Lain-Ego0/HighTorque-MiniDog/3.Document/7路CAN主控盒子资料/文档资料/01、python-SDK环境配置.pdf

# 01、python-SDK环境配置

## python-SDK环境配置

### 1. 下载程序

将程序下载在主机中，文件名为hightorque_robot

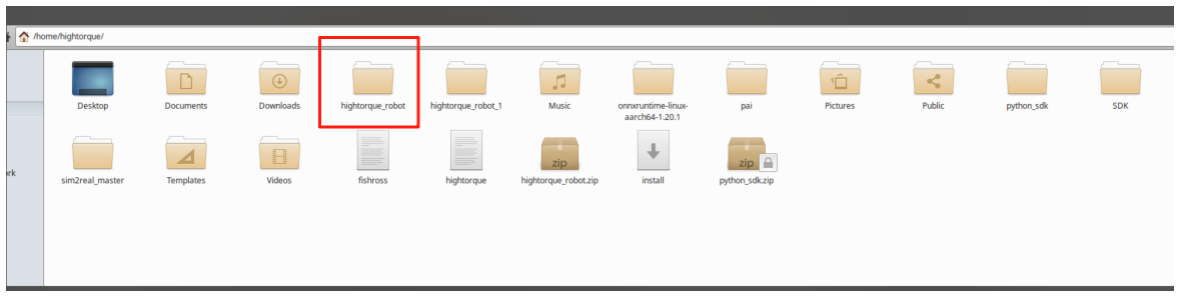
[picture p6: figure]

### 2. 下载系统依赖

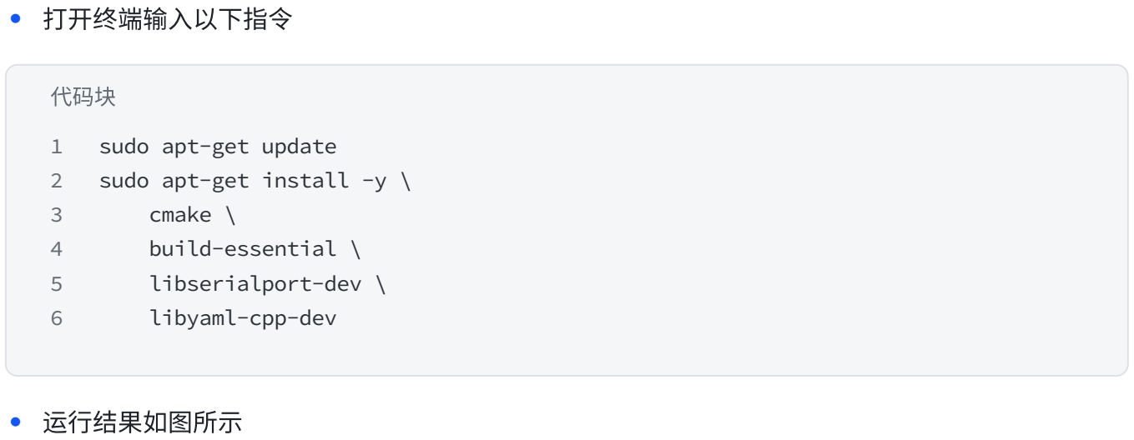
[picture p7: figure]
• 打开终端输入以下指令; 代码块; sudo apt-get update sudo apt-get install -y \ cmake \ build-essential \ libserialport-dev \ libyaml-cpp-dev; • 运行结果如图所示
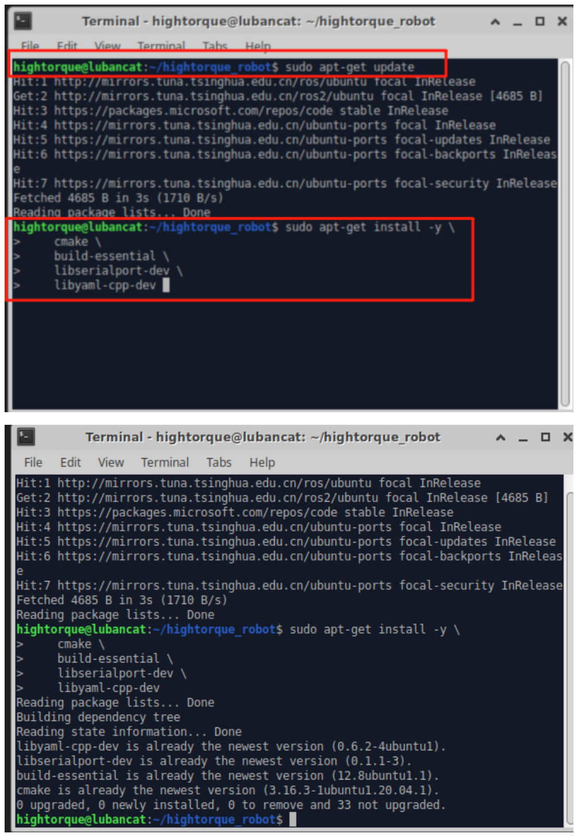
[picture p8: page 2]
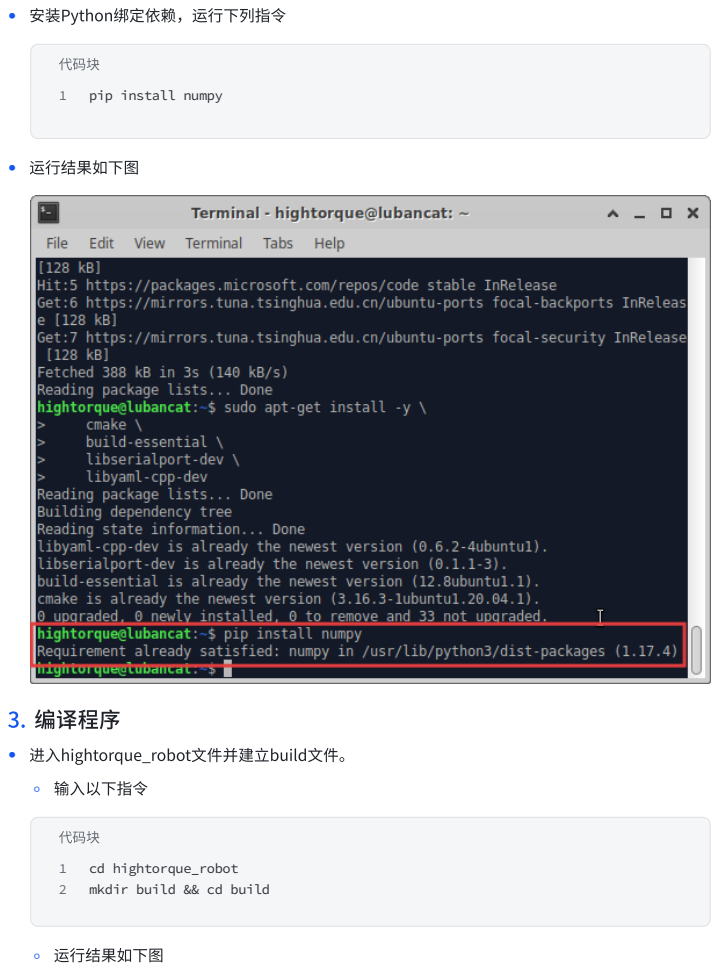
[picture p9: page 3]
• 安装Python绑定依赖，运行下列指令; • 运行结果如下图; 3. 编译程序; • 进入hightorque_robot文件并建立build文件。; ◦ 输入以下指令; ◦ 运行结果如下图

代码块
pip install numpy

cd hightorque_robot
mkdir build && cd build

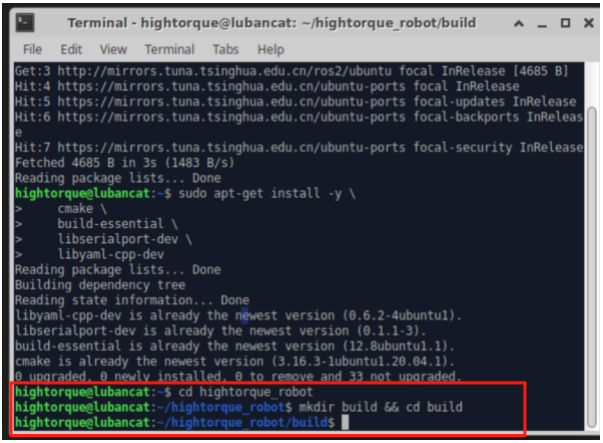
[picture p10: figure]
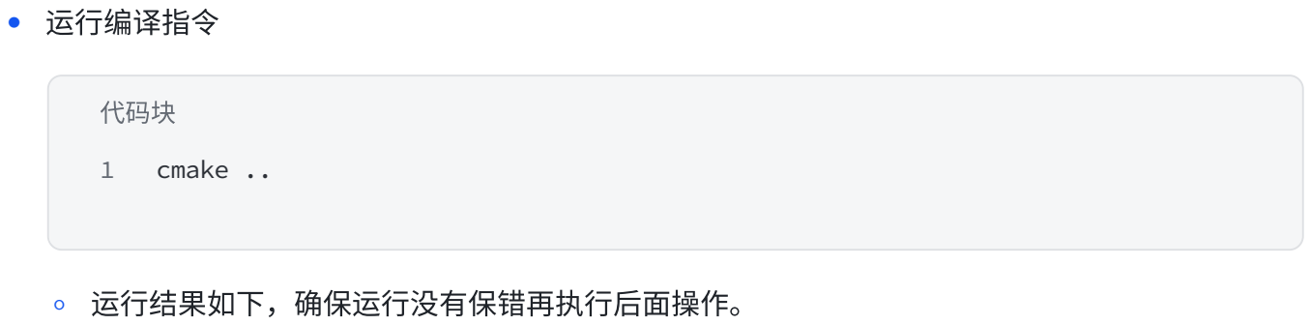
[picture p11: figure]
• 运行编译指令; 代码块; cmake ..; ◦ 运行结果如下，确保运行没有保错再执行后面操作。
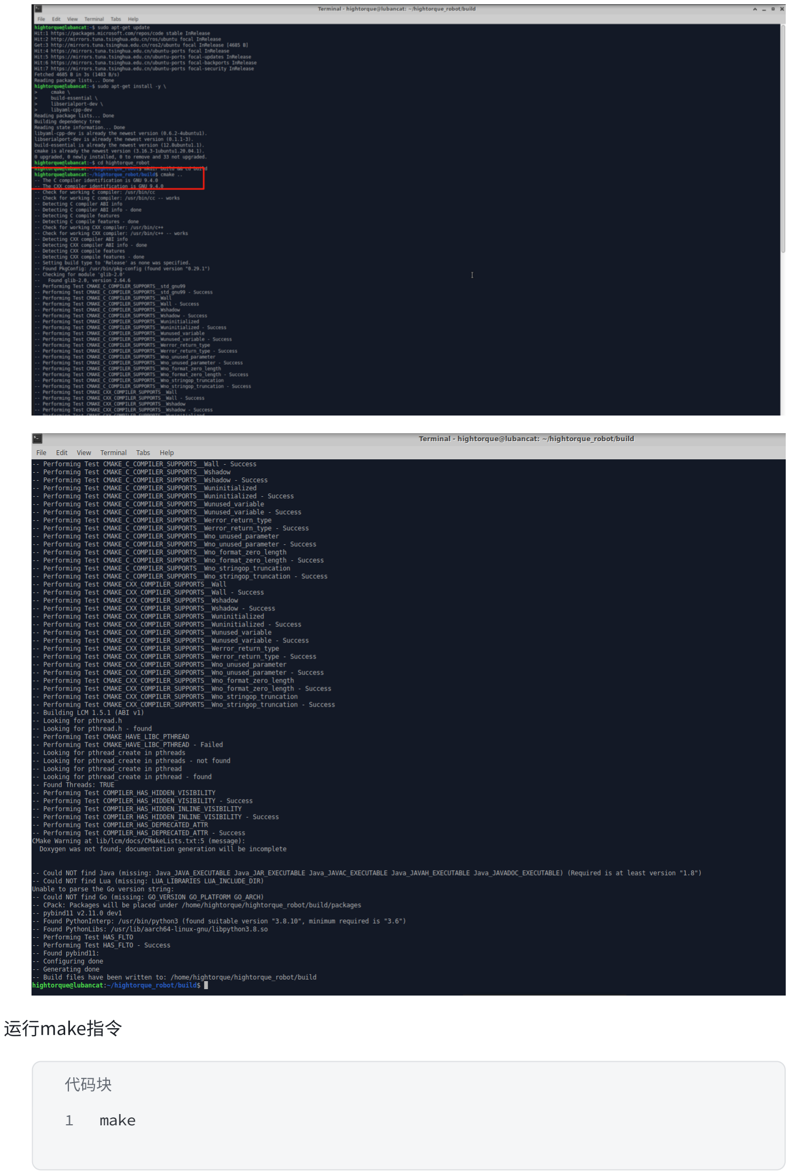
[picture p12: page 5]

运行make指令

代码块

### 1 make

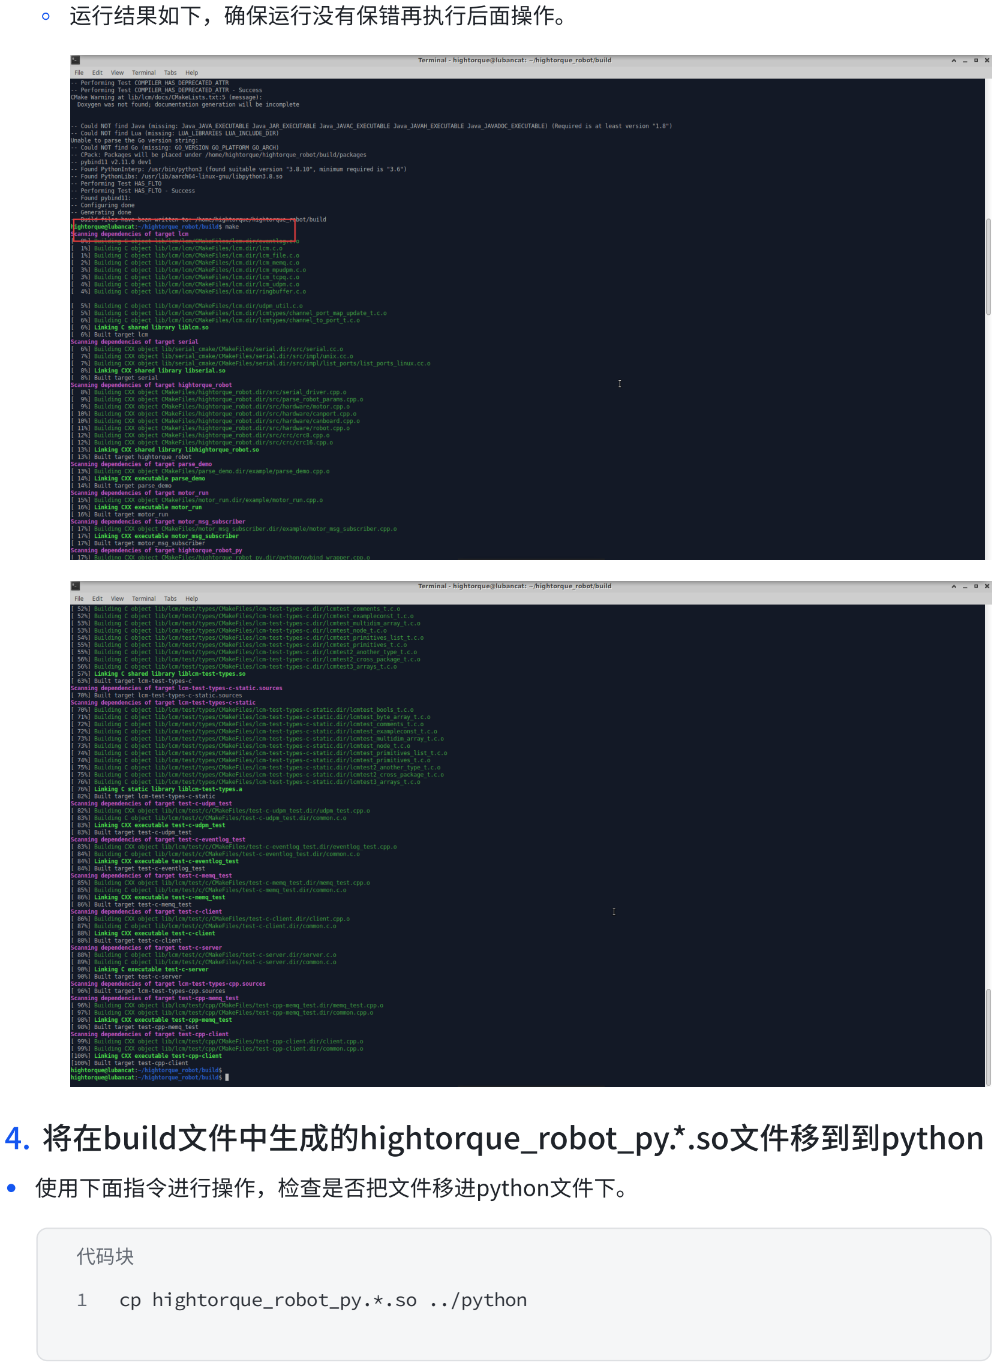
[picture p13: page 6]

- 运行结果如下，确保运行没有保错再执行后面操作。

## 4. 将在build文件中生成的hightorque_robot_py.*.so文件移到到python

- 使用下面指令进行操作，检查是否把文件移进python文件下。

代码块

### 1 cp hightorque_robot_py.*.so ../python

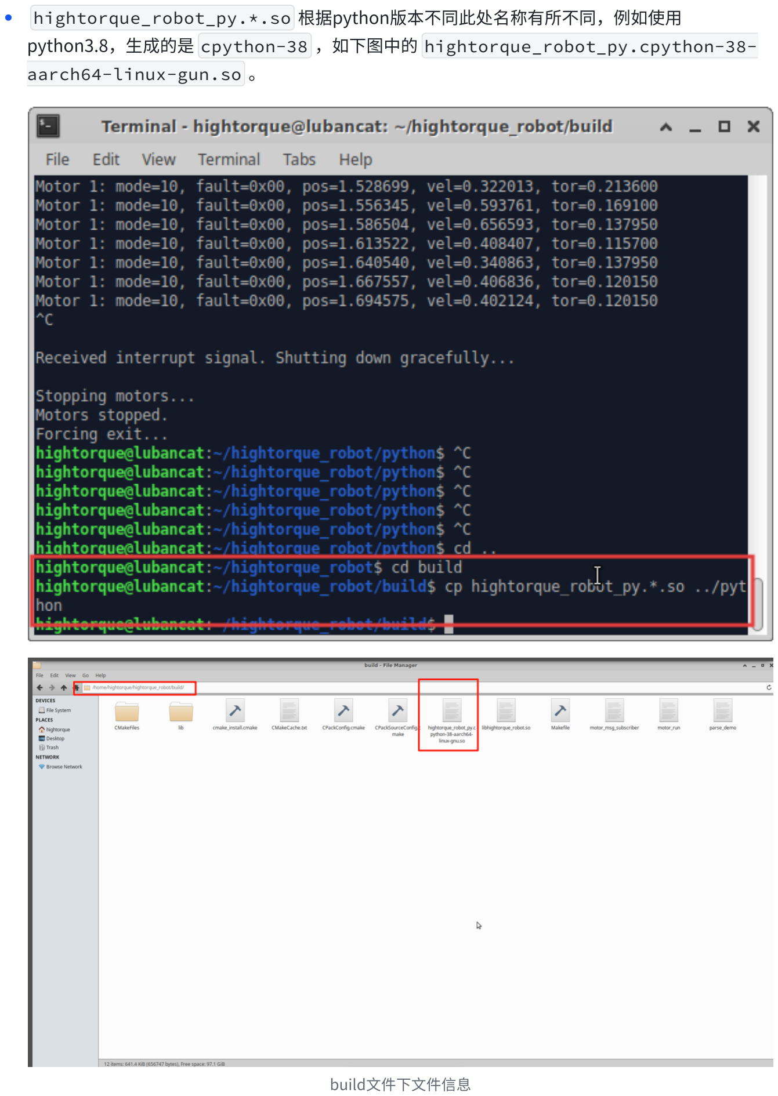
[picture p14: page 7]

- hightorque_robot_py.*.so 根据python版本不同此处名称有所不同，例如使用
python3.8，生成的是 cpython-38 ，如下图中的 | hightorque_robot_py.cpython-38-
aarch64-linux-gun.so | 。

build文件下文件信息

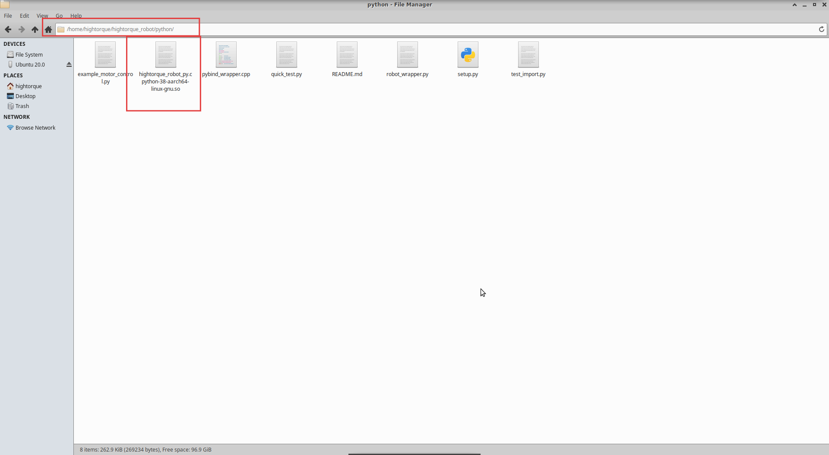
[picture p15: figure]

python文件下文件信息

## 5. 进入python文件运行测试程序

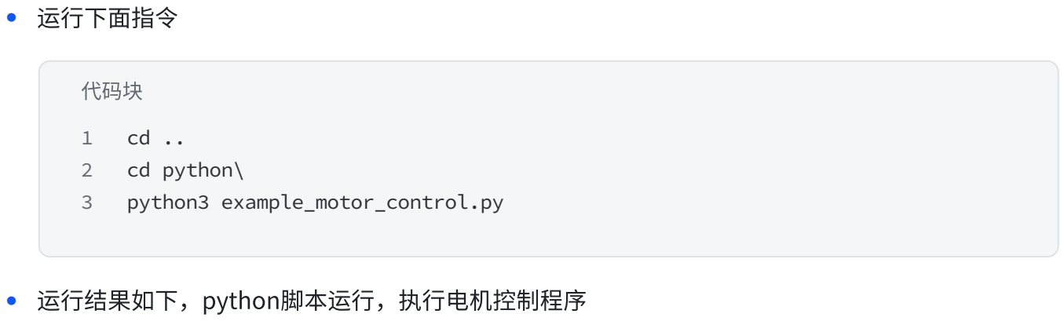
[picture p16: figure]
• 运行下面指令; 代码块; cd .. cd python\ python3 example_motor_control.py; • 运行结果如下，python脚本运行，执行电机控制程序

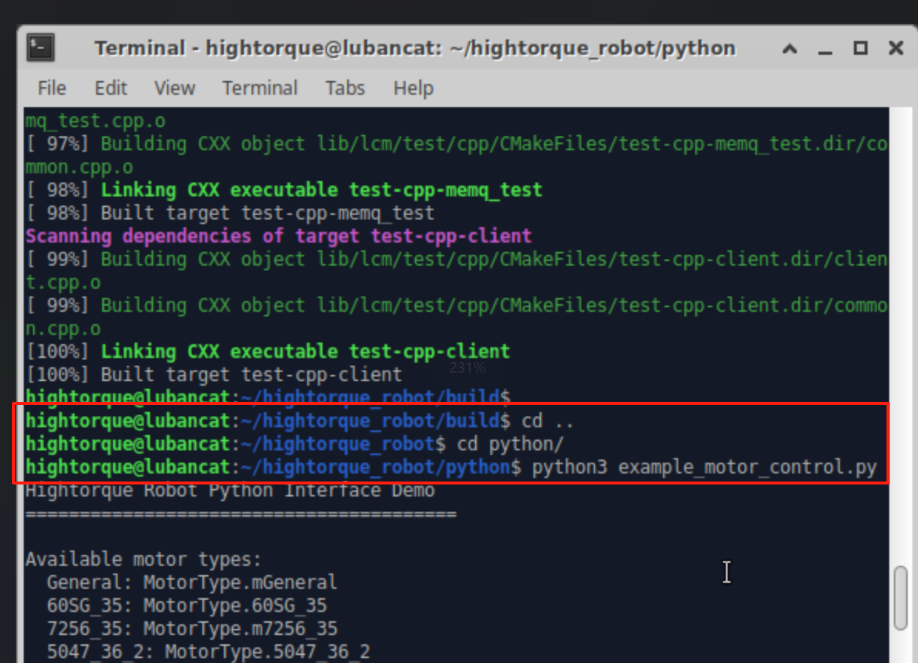
[picture p17: figure]
