Lain-Ego0/HighTorque-MiniDog/3.Document/高擎动力电池资料/电池参数.png

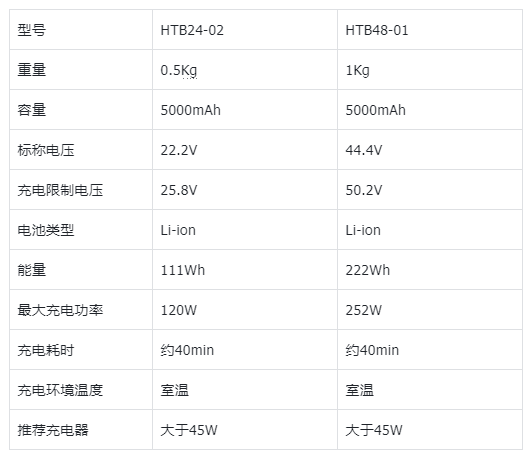
3.Document/高擎动力电池资料/电池参数.png
