Lain-Ego0/HighTorque-MiniDog/5.Images/V1.png

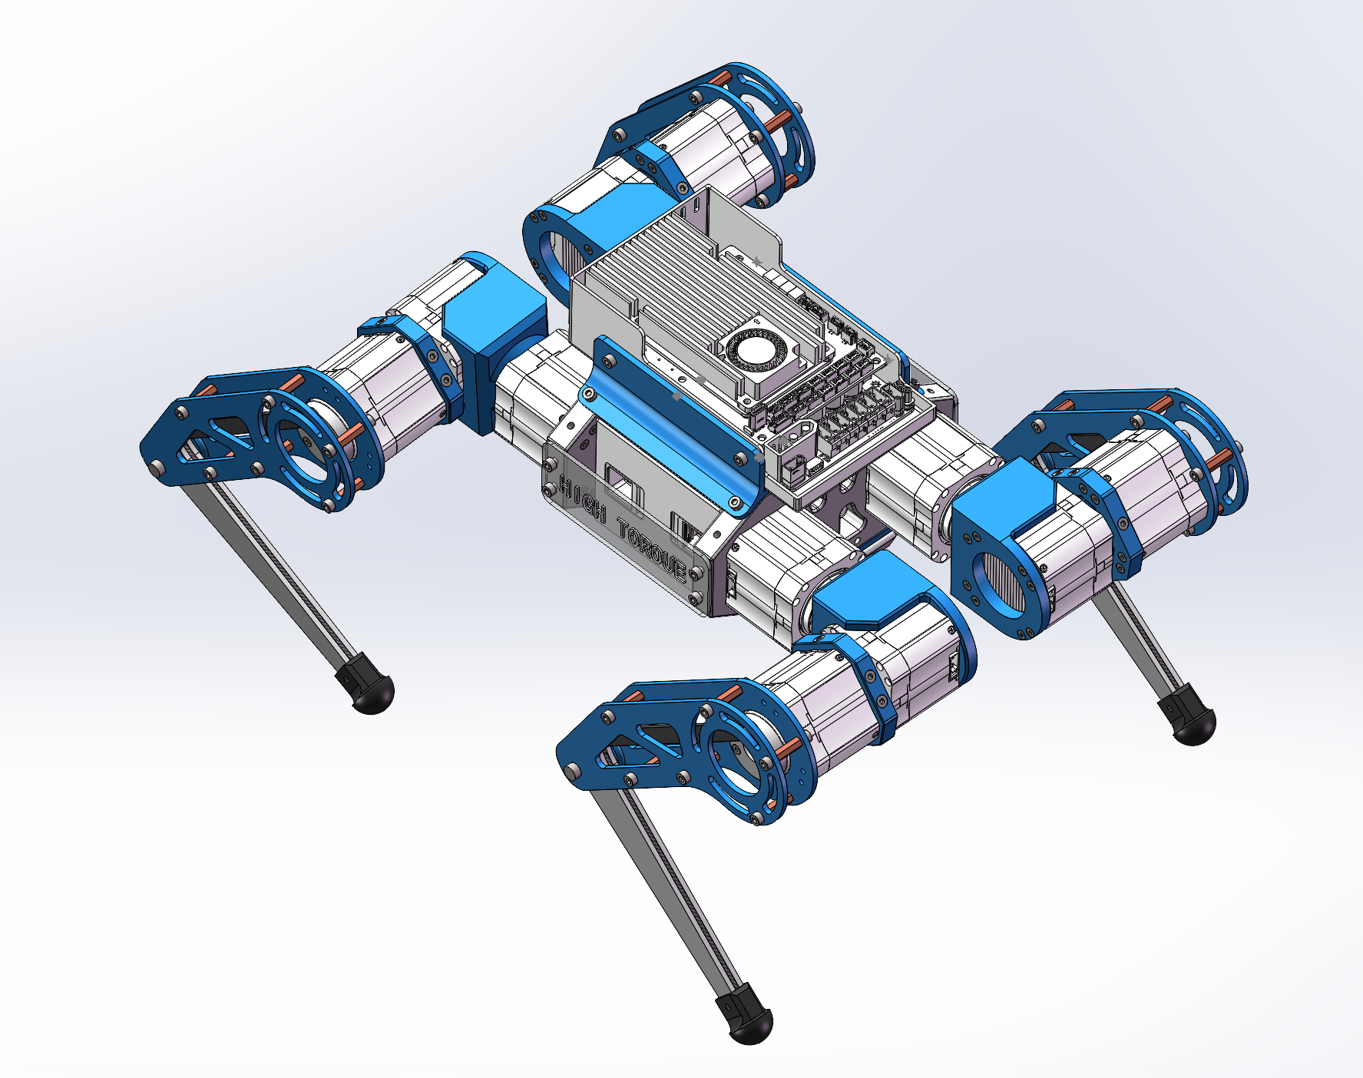
5.Images/V1.png
