Lain-Ego0/HighTorque-MiniDog/5.Images/V2.png

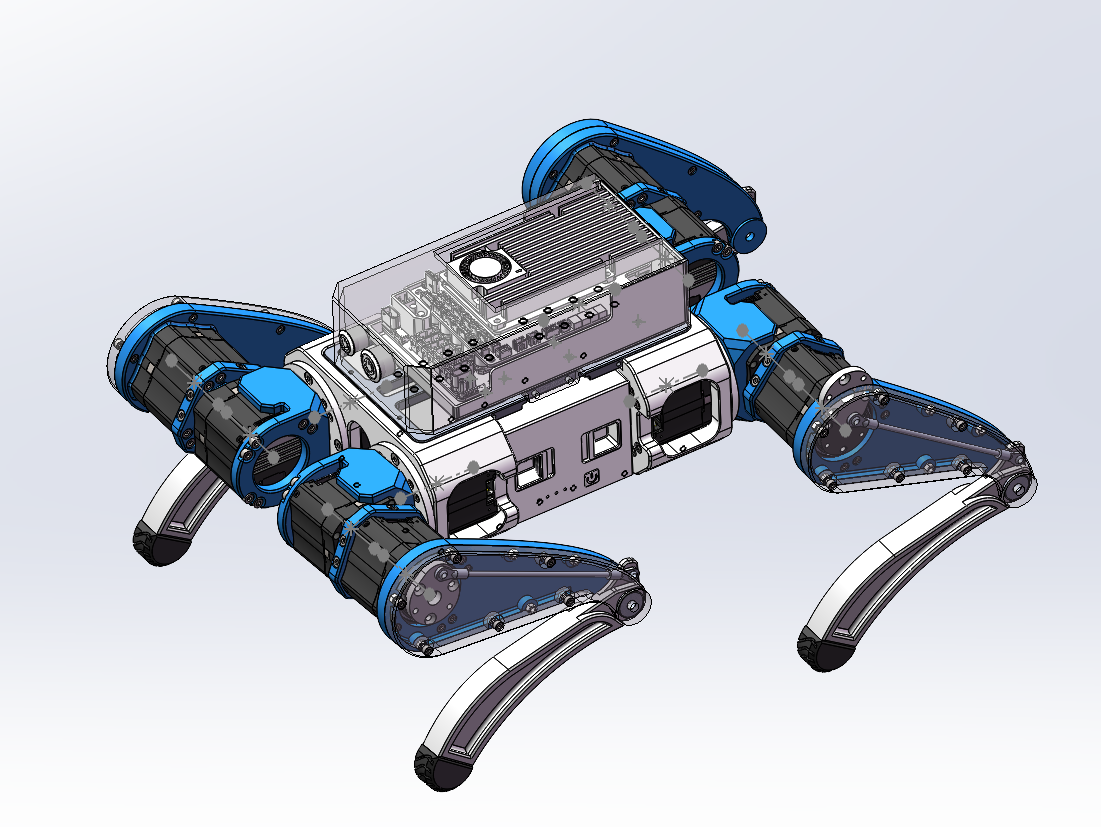
5.Images/V2.png
