Lain-Ego0/HighTorque-MiniDog/assets/image-20260120192404432.png

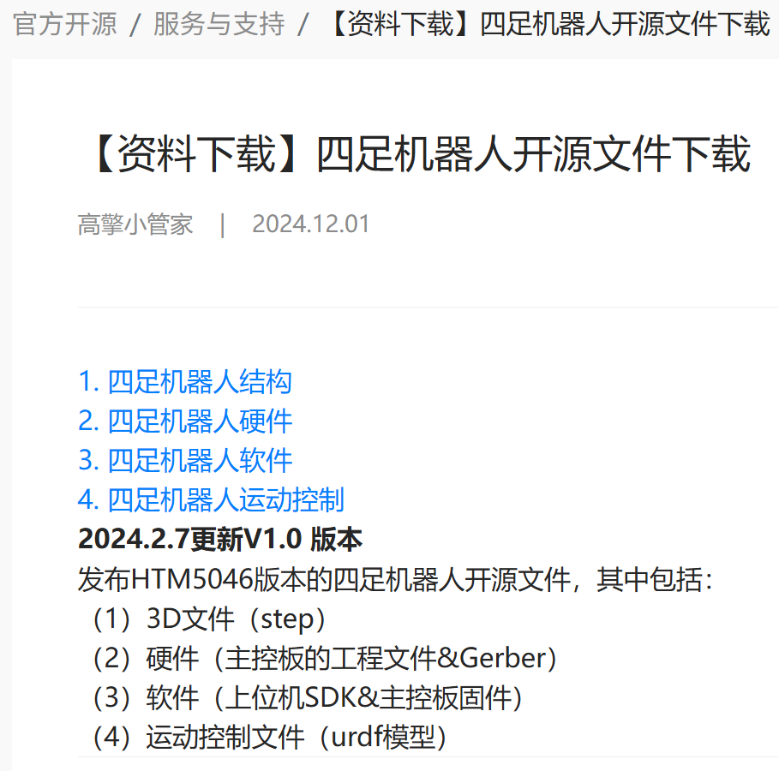
assets/image-20260120192404432.png
