Lain-Ego0/HighTorque-MiniDog/assets/image.png

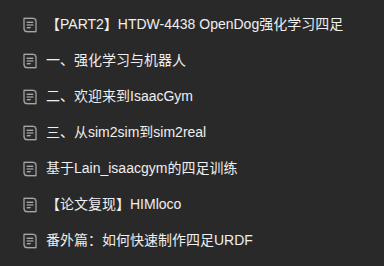
assets/image.png
