Lain-Ego0/HighTorque-MiniDog/BOM.xlsx

电机材料BOM表
商品简称 | 数量 | 单位 | 规格 | 型号 | 单价 | 总价 | 产品图片 | 链接
主控盒子 | 1 | 个 | 高擎机电 | RoBoBox-7C开发套件 RK3588核心板功率板 7路can | 2999 | 2999 | =DISPIMG("ID_BEA2C792CA2D4338877360D81E1C02E0",1) | https://item.taobao.com/item.htm?id=941964501774&skuId=5854163228933
HTM-4438 | 12 | 个 | 高擎机电 | HTM-4438 | 899 | 10788 | =DISPIMG("ID_2CC5A49AB6E142558D87F2EC8AF307A8",1) | https://item.taobao.com/item.htm?id=776280863227&skuId=5833834236346
高擎机电自研 BMS电池 | 1 | 个 | 高擎机电 | HTB24（24V） | 899 | 899 | =DISPIMG("ID_F9912B83E9324EAC948459F9C720646A",1) | https://item.taobao.com/item.htm?id=940034270930&skuId=6003633490738
XT30（2+2） | 12 | 条 | 高擎机电 | XT30（2+2）CAN端子线材 |  |  | =DISPIMG("ID_088166CB696247348FEB7CAEBC6838D0",1) | https://item.taobao.com/item.htm?id=940637805222&skuId=5836913516511
usb转can模块 | 1 | 个 | 高擎机电 | 电机调试器USB转CANFD | 88 | 88 | =DISPIMG("ID_DE37467A45FB48D49FF0A2E2A4B48DCD",1) | https://item.taobao.com/item.htm?id=803596739458&skuId=5838408897102
材料购买表
商品简称 | 数量 | 单位 | 规格 | 型号 |  |  | 产品图片 | 链接 | 用途
杯头螺丝 | 1 | 件 | M2.5*20[50个] | SZ105-国标DIN912 | 4.8 | 4.8 | =DISPIMG("ID_5A68CB2C8CF24C4B8B75CCBF4D84C922",1)
杯头螺丝 | 1 | 件 | M3*10[50个] | SZ105-国标DIN912 | 2.7 | 2.7 | =DISPIMG("ID_DF31851D3177447E9443667D950D5D3B",1)
杯头螺丝 | 1 | 件 | M3*12[50个] | SZ105-国标DIN912 | 3 | 3 | =DISPIMG("ID_CCA8D6D92B4B4D15A3308F70EC4EE083",1)
杯头螺丝 | 1 | 件 | M3*15[50个] | SZ105-国标DIN912 | 3.6 | 3.6 | =DISPIMG("ID_BB62620DB465445DBE867C79ED09E9B8",1)
杯头螺丝 | 1 | 件 | M3*25[50个] | SZ105-国标DIN912 | 4.5 | 4.5 | =DISPIMG("ID_6C18F41A81C94DC6A925279E1ABA02BE",1)
杯头螺丝 | 1 | 件 | M3*35[50个] | SZ105-国标DIN912 | 2.7 | 2.7 | =DISPIMG("ID_9DF53531F7B04B88BADECE2428534E32",1)
杯头螺丝 | 1 | 件 | M3*40[50个] | SZ105-国标DIN912 | 3.1 | 3.1 | =DISPIMG("ID_303DC5F60FD74723B0BED9BF9463948D",1)
杯头螺丝 | 1 | 件 | M5*20[20个] | SZ105-国标DIN912 | 3.9 | 3.9 | =DISPIMG("ID_ECDE7BB7A42643D2BEAAFBF641936D92",1)
杯头螺丝 | 1 | 件 | M5*30[10个] | SZ105-国标DIN912 | 2.5 | 2.5 | =DISPIMG("ID_E0697B837510405E99F7B9D1F8C5C177",1)
螺母 | 1 | 包 | M2.5【304材质】*20颗 | SZ124-003 | 3.6 | 3.6 | =DISPIMG("ID_4435505E4D3444C2B49B932C982A96F8",1)
螺母 | 1 | 包 | M3【304材质】*50颗 | SZ124-003 | 3.4 | 3.4 | =DISPIMG("ID_ED4B863F285F4AD9A9C094EA965BB35C",1)
螺母 | 1 | 包 | M5【304材质】*50颗 | SZ124-003 | 3.9 | 3.9 | =DISPIMG("ID_0244CC1D4A954542B4BEE1F289BDAF5E",1)
法兰轴承 | 3 | 件 | 5*13*4 10只 | F MF2-5 | 19 | 57 | =DISPIMG("ID_47ADE4DCB12949CF979BCA55C94982DE",1)
尼龙柱 | 1 | 包 | 3.2*5*25(100个) | 1170 | 9.5 | 9.5 | =DISPIMG("ID_37CDDA6D06C34113926942D377090F54",1)
轮胎 | 2 | 个 | 江昕5x2实心胎 | 5.5x2 | 30 | 60 | =DISPIMG("ID_6E9682AB056F46BB87A38954D99A1416",1)
垫片 | 1 | 包 | M5*8*0.5 [100粒 | GB97 | 3 | 3 | =DISPIMG("ID_CEC6477D13B24A38A034292F6B30D398",1)
