Lain-Ego0/HighTorque-MiniDog/1.Hardware/HTDW4438-OpenDogV1.5/铝-CNC连杆-发加工版本.SLDPRT

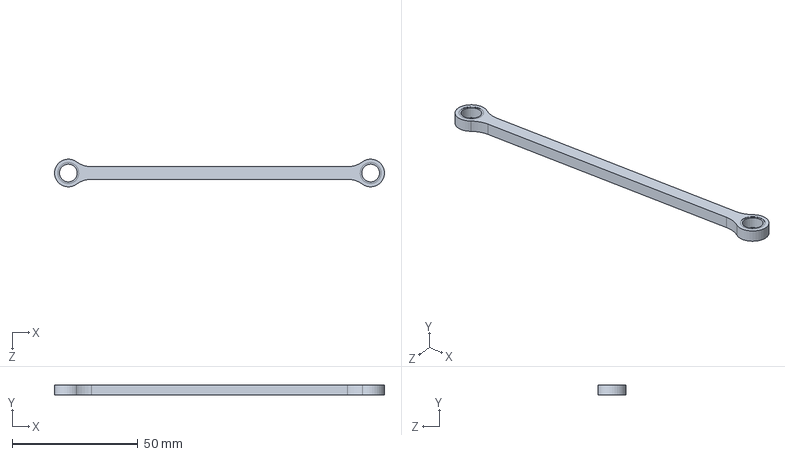
[picture p23: CAD file, 2026-01-23]
1.Hardware/HTDW4438-OpenDogV1.5/铝-CNC连杆-发加工版本.SLDPRT
131.0 x 4.00 x 11.0 mm
