Lain-Ego0/HighTorque-MiniDog/1.Hardware/HTDW4438-OpenDog（URDF）/hip^总装配体.SLDPRT

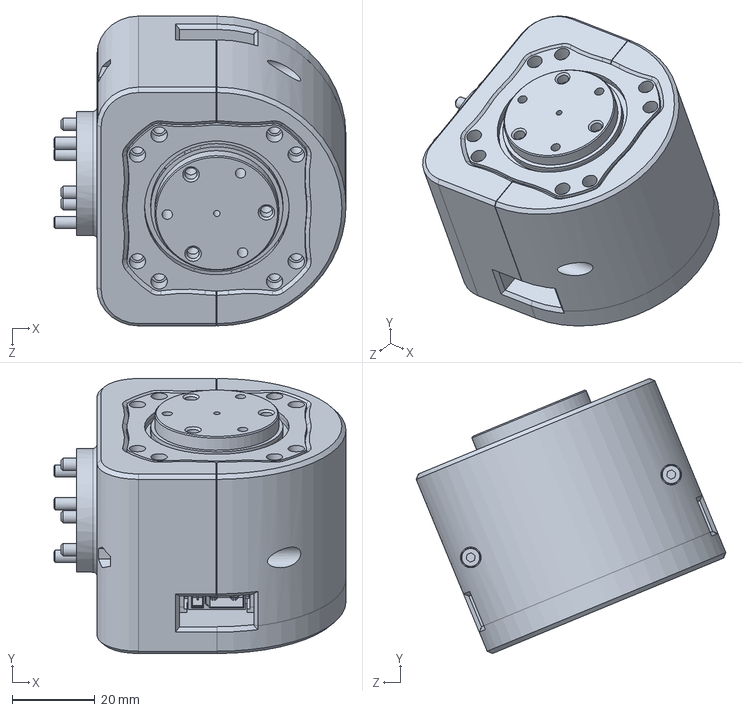
[picture p24: CAD file, 2026-01-23]
1.Hardware/HTDW4438-OpenDog（URDF）/hip^总装配体.SLDPRT
70.7 x 66.5 x 74.9 mm
