Lain-Ego0/HighTorque-MiniDog/1.Hardware/htdw_4438_urdf/meshes/RR_hip.STL

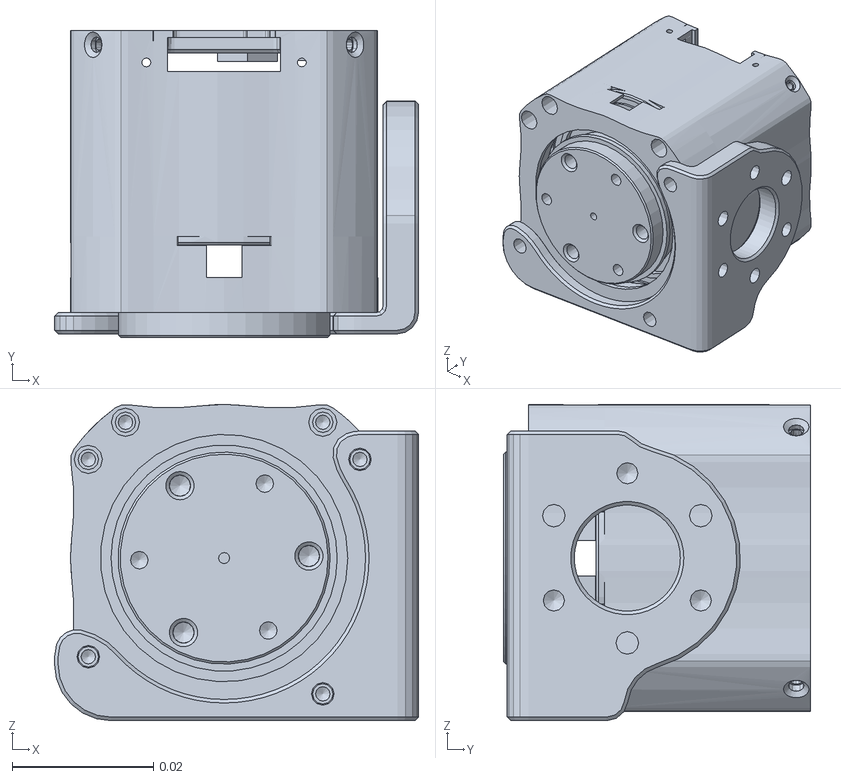
[picture p25: CAD file, 2026-03-19]
1.Hardware/htdw_4438_urdf/meshes/RR_hip.STL
0.0515 x 0.0434 x 0.0447
