Lain-Ego0/HighTorque-MiniDog/1.Hardware/HTDW4438-OpenDogV1.5/小腿1.SLDPRT

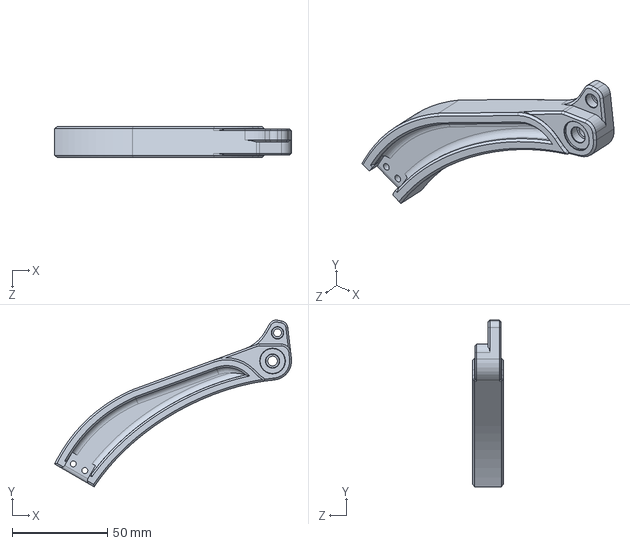
[picture p26: CAD file, 2026-01-23]
1.Hardware/HTDW4438-OpenDogV1.5/小腿1.SLDPRT
124.3 x 87.5 x 16.0 mm
