Lain-Ego0/HighTorque-MiniDog/1.Hardware/HTDW4438-OpenDog（URDF）/R_foot^总装配体.SLDPRT

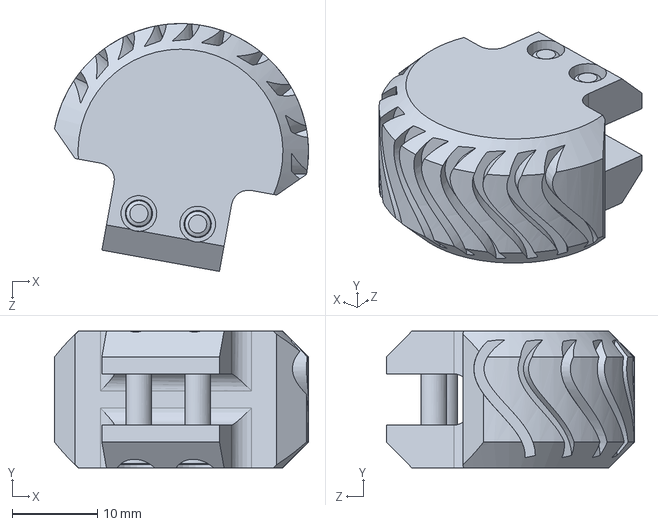
[picture p27: CAD file, 2026-01-23]
1.Hardware/HTDW4438-OpenDog（URDF）/R_foot^总装配体.SLDPRT
29.8 x 16.0 x 29.0 mm
