Lain-Ego0/HighTorque-MiniDog/1.Hardware/htdw_4438_urdf/meshes/FL_foot.STL

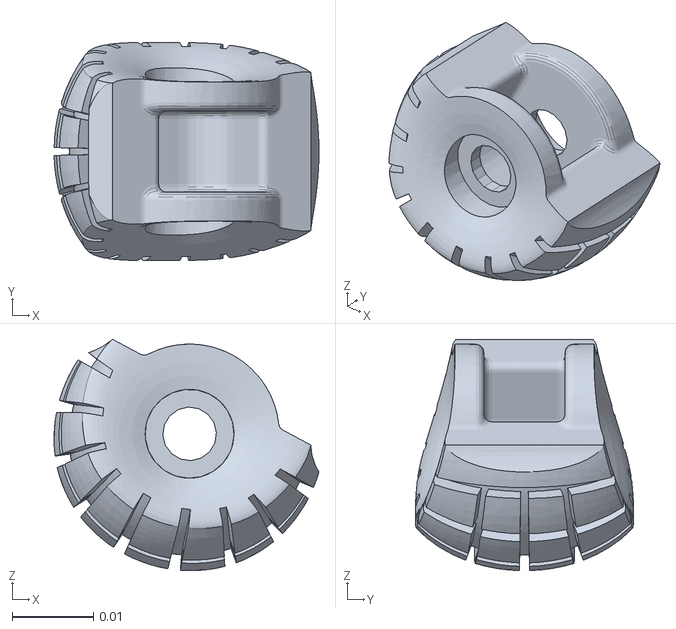
[picture p28: CAD file, 2026-03-19]
1.Hardware/htdw_4438_urdf/meshes/FL_foot.STL
0.0326 x 0.0269 x 0.0285
