Lain-Ego0/HighTorque-MiniDog/1.Hardware/HTDW4438-OpenDogV1.5/大腿内侧2.SLDPRT

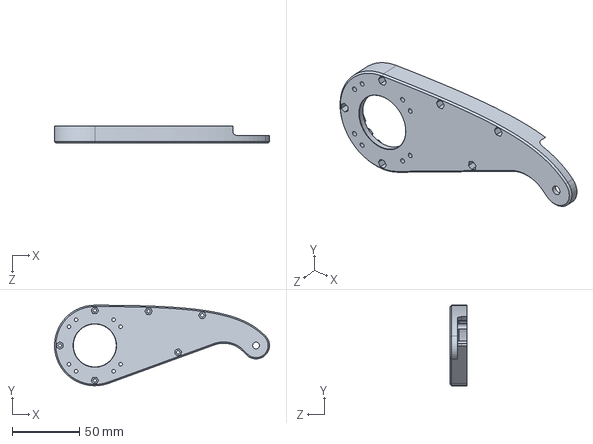
[picture p29: CAD file, 2026-01-23]
1.Hardware/HTDW4438-OpenDogV1.5/大腿内侧2.SLDPRT
160.0 x 60.0 x 12.5 mm
