Lain-Ego0/HighTorque-MiniDog/1.Hardware/HTDW4438-OpenDog（URDF）/R_calf^总装配体.SLDPRT

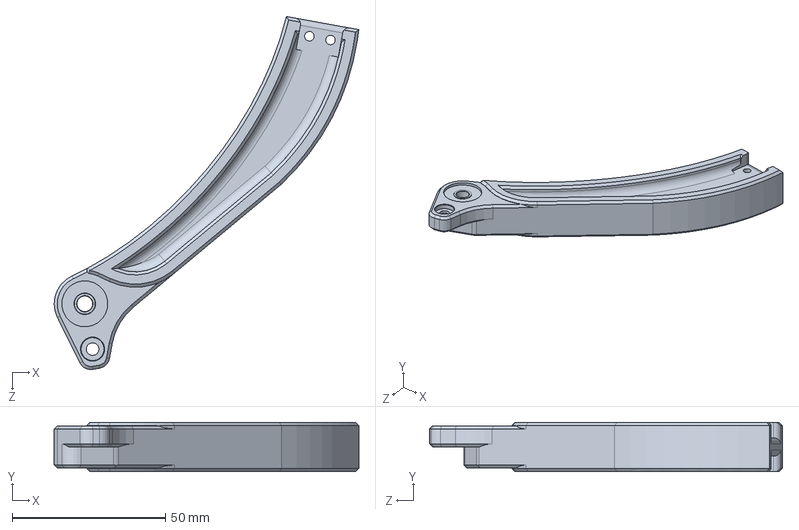
[picture p30: CAD file, 2026-01-23]
1.Hardware/HTDW4438-OpenDog（URDF）/R_calf^总装配体.SLDPRT
99.4 x 16.0 x 115.1 mm
