Lain-Ego0/HighTorque-MiniDog/1.Hardware/htdw_4438_urdf/meshes/FR_calf.STL

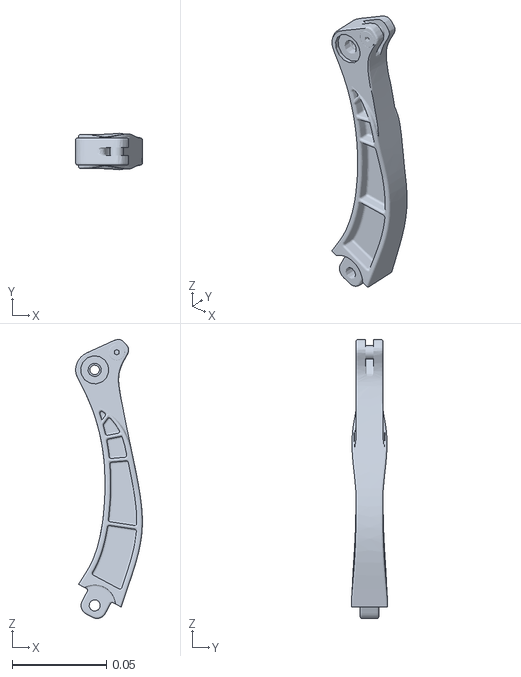
[picture p31: CAD file, 2026-03-19]
1.Hardware/htdw_4438_urdf/meshes/FR_calf.STL
0.0355 x 0.0194 x 0.148
