Lain-Ego0/HighTorque-MiniDog/1.Hardware/HTDW4438-OpenDogV1.5/髋关节连接2.SLDPRT

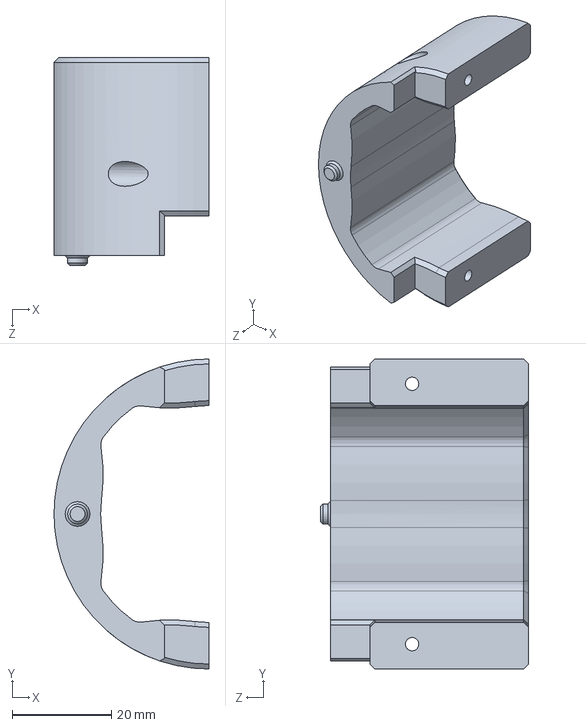
[picture p32: CAD file, 2026-01-23]
1.Hardware/HTDW4438-OpenDogV1.5/髋关节连接2.SLDPRT
31.2 x 62.5 x 42.0 mm
