Lain-Ego0/HighTorque-MiniDog/1.Hardware/HTDW4438-OpenDog（URDF）/L_foot^总装配体.SLDPRT

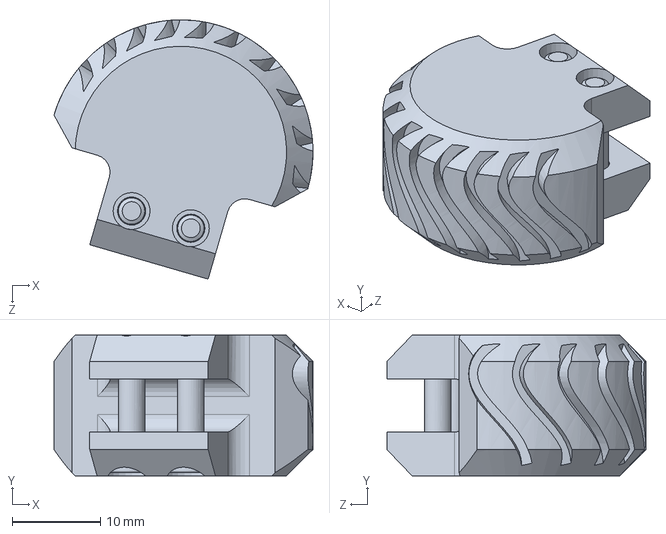
[picture p33: CAD file, 2026-01-23]
1.Hardware/HTDW4438-OpenDog（URDF）/L_foot^总装配体.SLDPRT
29.4 x 16.0 x 29.4 mm
