Lain-Ego0/HighTorque-MiniDog/1.Hardware/HTDW4438-OpenDogV1.5/M4防松螺母.SLDPRT

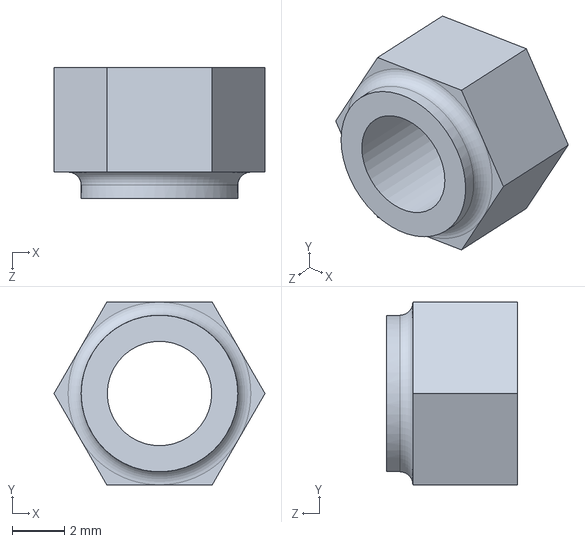
[picture p34: CAD file, 2026-01-23]
1.Hardware/HTDW4438-OpenDogV1.5/M4防松螺母.SLDPRT
8.08 x 7.00 x 5.00 mm
