Lain-Ego0/HighTorque-MiniDog/1.Hardware/HTDW4438-OpenDog（URDF）/L_calf^总装配体.SLDPRT

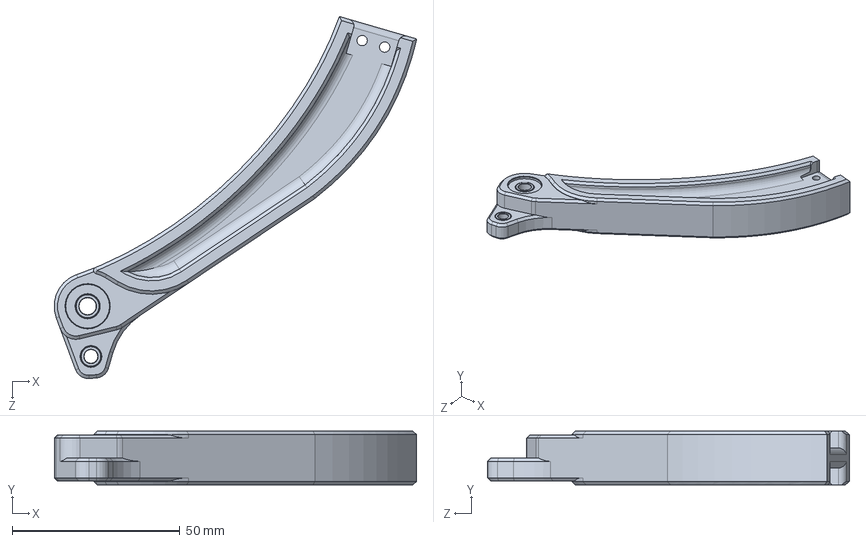
[picture p35: CAD file, 2026-01-23]
1.Hardware/HTDW4438-OpenDog（URDF）/L_calf^总装配体.SLDPRT
108.1 x 16.0 x 107.9 mm
