Lain-Ego0/HighTorque-MiniDog/1.Hardware/htdw_4438_urdf/meshes/FR_thigh.STL

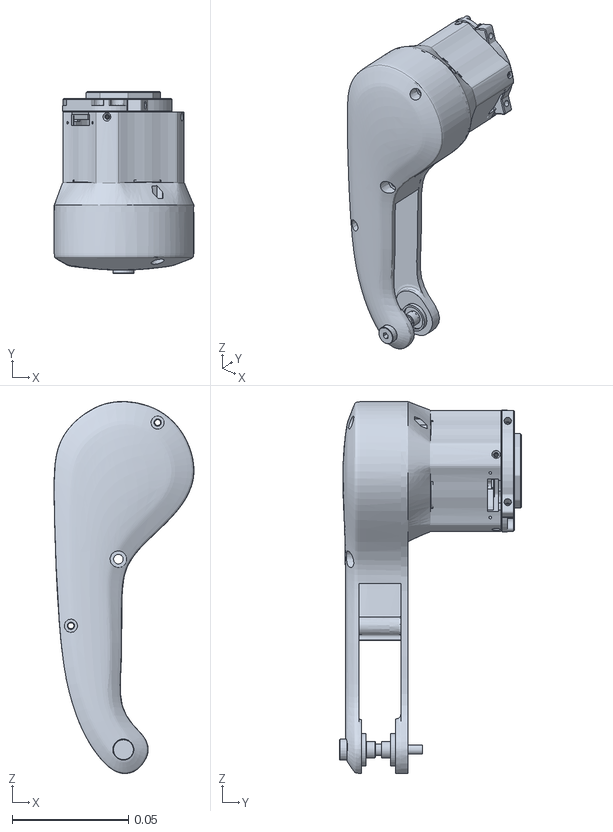
[picture p36: CAD file, 2026-03-19]
1.Hardware/htdw_4438_urdf/meshes/FR_thigh.STL
0.0602 x 0.0785 x 0.16
