Lain-Ego0/HighTorque-MiniDog/1.Hardware/HTDW4438-OpenDogV1.5/GB╱T 70.1-2008[内六角圆柱头螺钉M3×20].sldprt

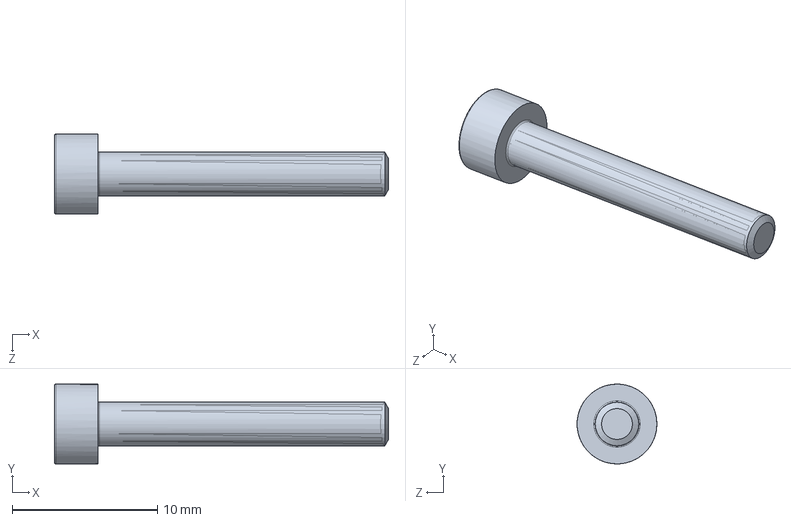
[picture p37: CAD file, 2026-01-23]
1.Hardware/HTDW4438-OpenDogV1.5/GB╱T 70.1-2008[内六角圆柱头螺钉M3×20].sldprt
23.0 x 5.50 x 5.50 mm
