Lain-Ego0/HighTorque-MiniDog/1.Hardware/HTDW4438-OpenDogV1.5/304搭扣4.SLDPRT

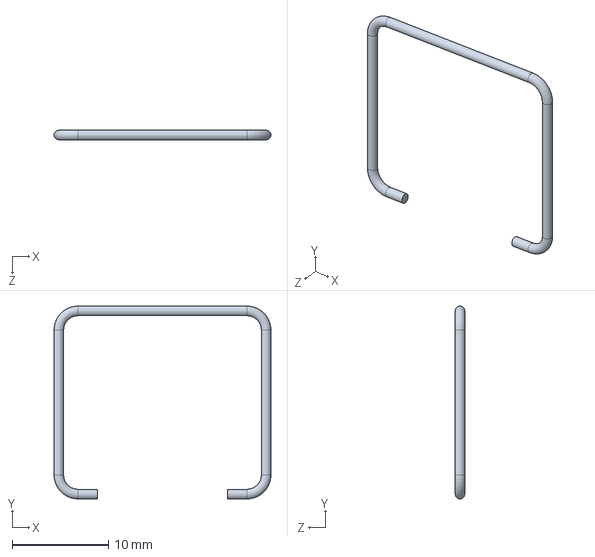
[picture p39: CAD file, 2026-01-23]
1.Hardware/HTDW4438-OpenDogV1.5/304搭扣4.SLDPRT
22.5 x 20.0 x 1.00 mm
