Lain-Ego0/HighTorque-MiniDog/1.Hardware/HTDW4438-OpenDogV1.5/肘关节连接.SLDPRT

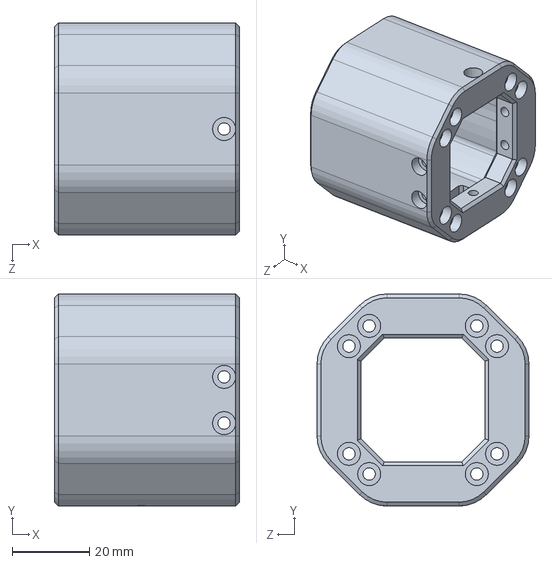
[picture p40: CAD file, 2026-01-23]
1.Hardware/HTDW4438-OpenDogV1.5/肘关节连接.SLDPRT
48.0 x 55.0 x 55.0 mm
