Lain-Ego0/HighTorque-MiniDog/1.Hardware/HTDW4438-OpenDogV1.5/304搭扣2.SLDPRT

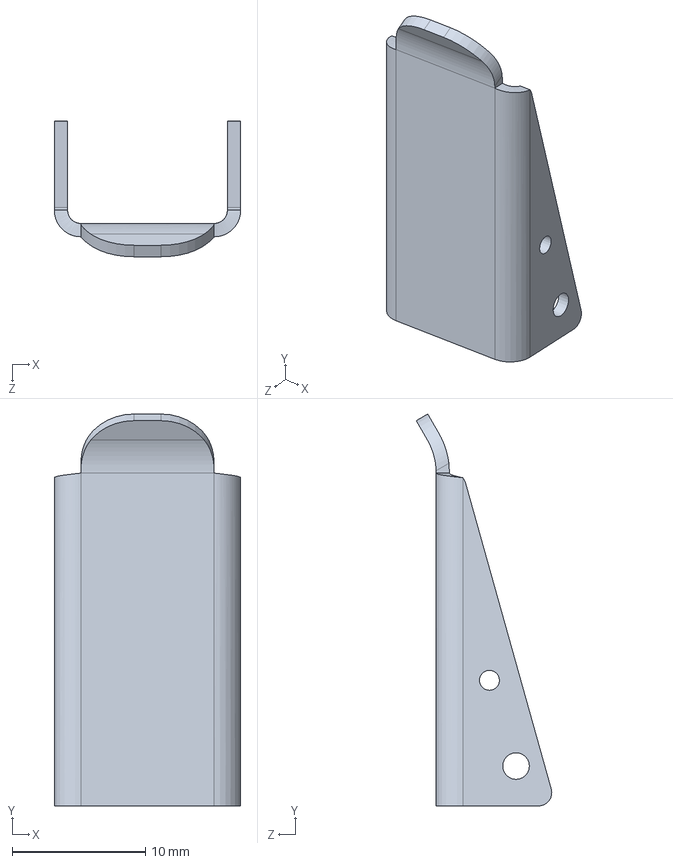
[picture p41: CAD file, 2026-01-23]
1.Hardware/HTDW4438-OpenDogV1.5/304搭扣2.SLDPRT
14.0 x 29.4 x 10.2 mm
