Lain-Ego0/HighTorque-MiniDog/1.Hardware/HTDW4438-OpenDogV1.5/内六角塞打螺栓 5xM4x20.SLDPRT

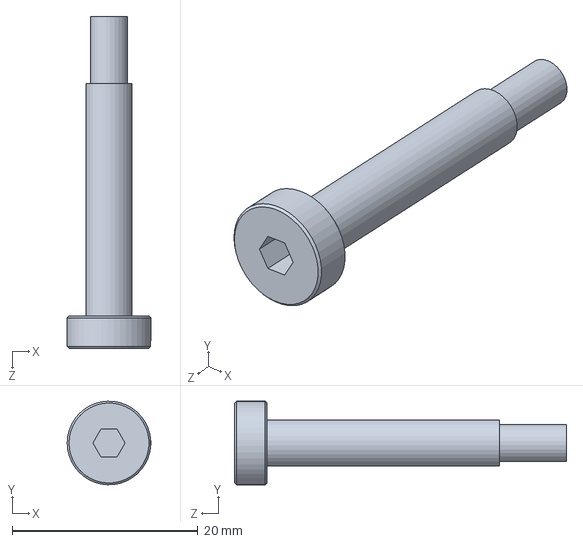
[picture p42: CAD file, 2026-01-23]
1.Hardware/HTDW4438-OpenDogV1.5/内六角塞打螺栓 5xM4x20.SLDPRT
9.00 x 8.99 x 35.7 mm
