Lain-Ego0/HighTorque-MiniDog/1.Hardware/htdw_4438_urdf/meshes/FR_hip.STL

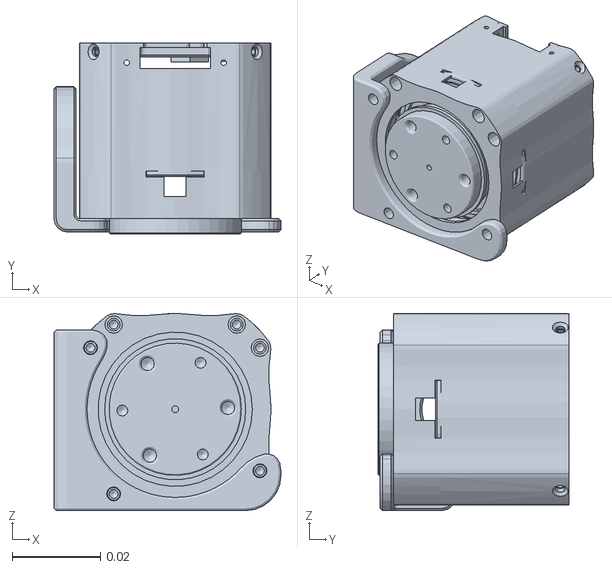
[picture p43: CAD file, 2026-03-19]
1.Hardware/htdw_4438_urdf/meshes/FR_hip.STL
0.0515 x 0.0434 x 0.0447
