Lain-Ego0/HighTorque-MiniDog/1.Hardware/HTDW4438-OpenDogV1.5/法兰挡边轴承MF74.SLDPRT

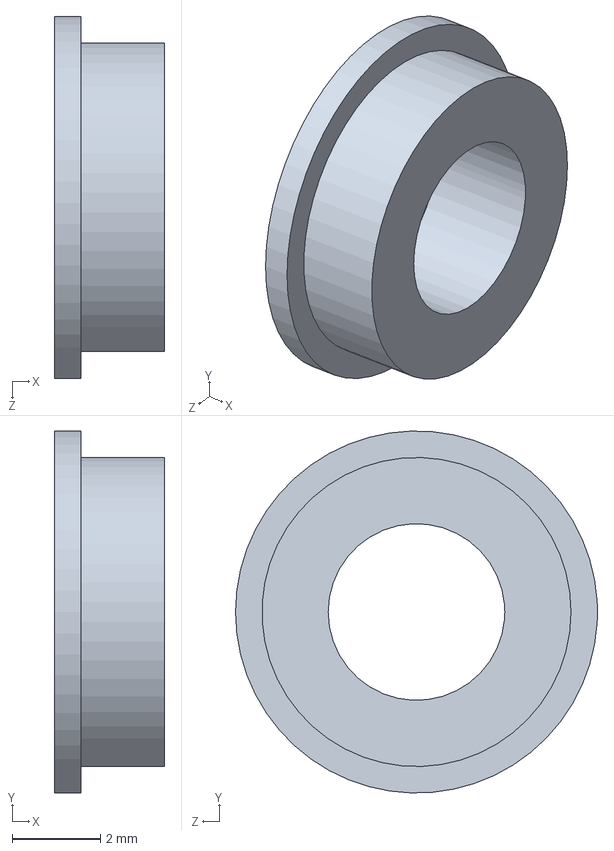
[picture p44: CAD file, 2026-01-23]
1.Hardware/HTDW4438-OpenDogV1.5/法兰挡边轴承MF74.SLDPRT
2.50 x 8.20 x 8.20 mm
