Lain-Ego0/HighTorque-MiniDog/1.Hardware/HTDW4438-OpenDogV1.5/GB╱T 70.1-2008[内六角圆柱头螺钉M2.5×20].SLDPRT

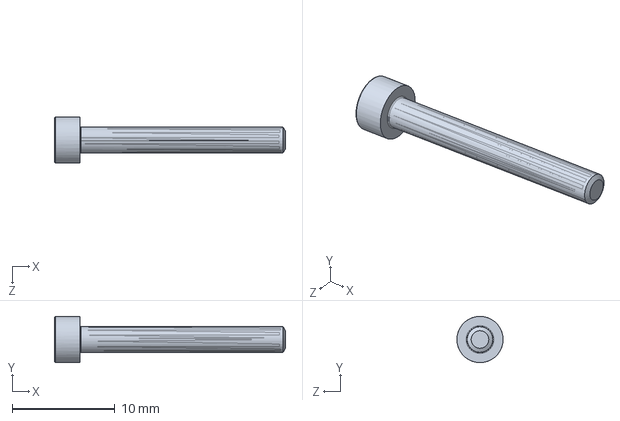
[picture p45: CAD file, 2026-01-23]
1.Hardware/HTDW4438-OpenDogV1.5/GB╱T 70.1-2008[内六角圆柱头螺钉M2.5×20].SLDPRT
22.5 x 4.50 x 4.50 mm
