Lain-Ego0/HighTorque-MiniDog/1.Hardware/HTDW4438-OpenDogV1.5/销钉M3-8.SLDPRT

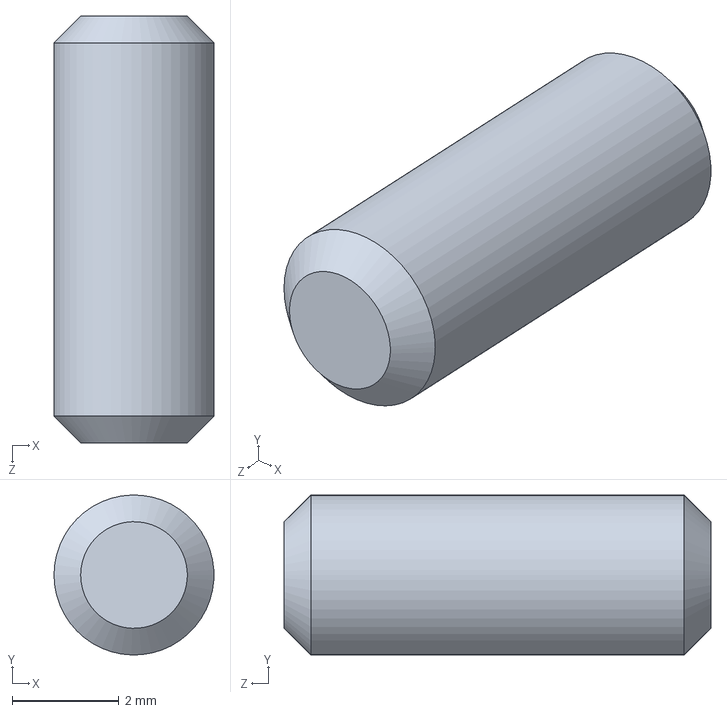
[picture p46: CAD file, 2026-01-23]
1.Hardware/HTDW4438-OpenDogV1.5/销钉M3-8.SLDPRT
3.00 x 3.00 x 8.00 mm
