Lain-Ego0/HighTorque-MiniDog/1.Hardware/HTDW4438-OpenDogV1.5/304搭扣3.SLDPRT

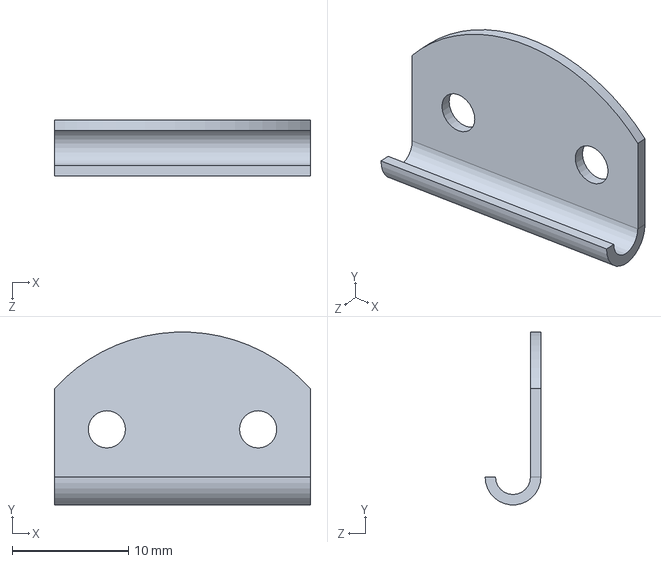
[picture p47: CAD file, 2026-01-23]
1.Hardware/HTDW4438-OpenDogV1.5/304搭扣3.SLDPRT
22.0 x 14.8 x 4.80 mm
