Lain-Ego0/HighTorque-MiniDog/1.Hardware/HTDW4438-OpenDogV1.5/薄壁深沟球30-37-4.SLDPRT

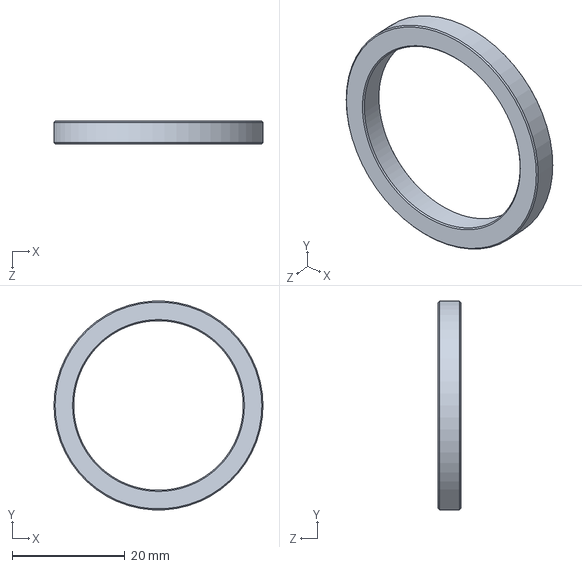
[picture p48: CAD file, 2026-01-23]
1.Hardware/HTDW4438-OpenDogV1.5/薄壁深沟球30-37-4.SLDPRT
37.0 x 36.9 x 4.00 mm
