Lain-Ego0/HighTorque-MiniDog/1.Hardware/HTDW4438-OpenDogV1.5/滚花热熔螺母 M3-4.5-4.5.SLDPRT

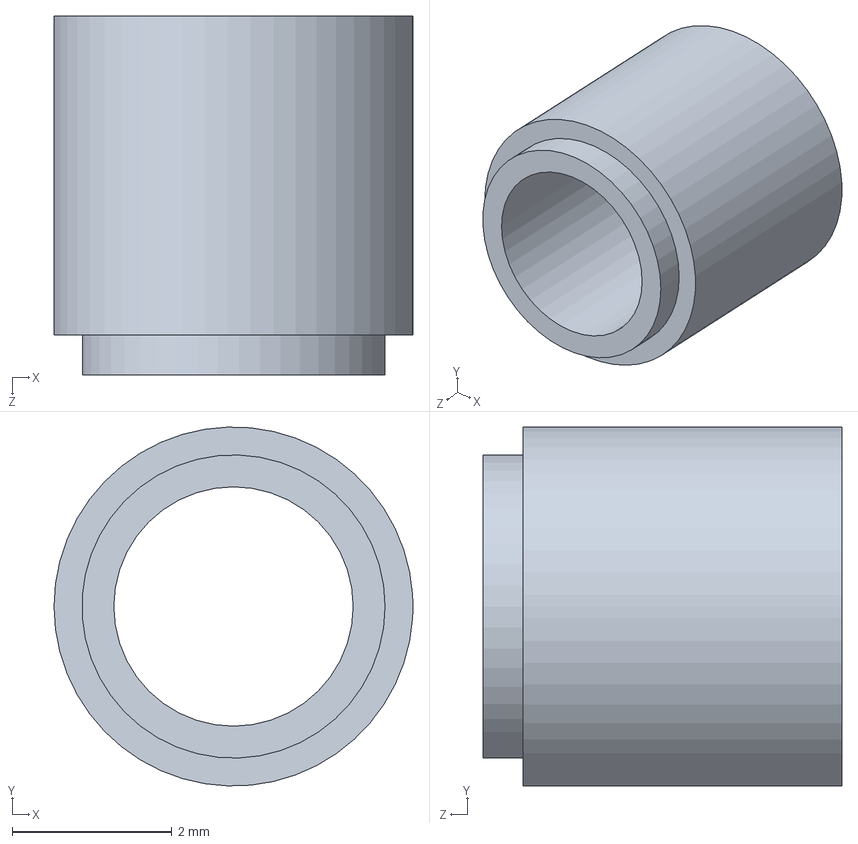
[picture p49: CAD file, 2026-01-23]
1.Hardware/HTDW4438-OpenDogV1.5/滚花热熔螺母 M3-4.5-4.5.SLDPRT
4.50 x 4.50 x 4.50 mm
