Lain-Ego0/HighTorque-MiniDog/1.Hardware/HTDW4438-OpenDogV1.5/足端.SLDPRT

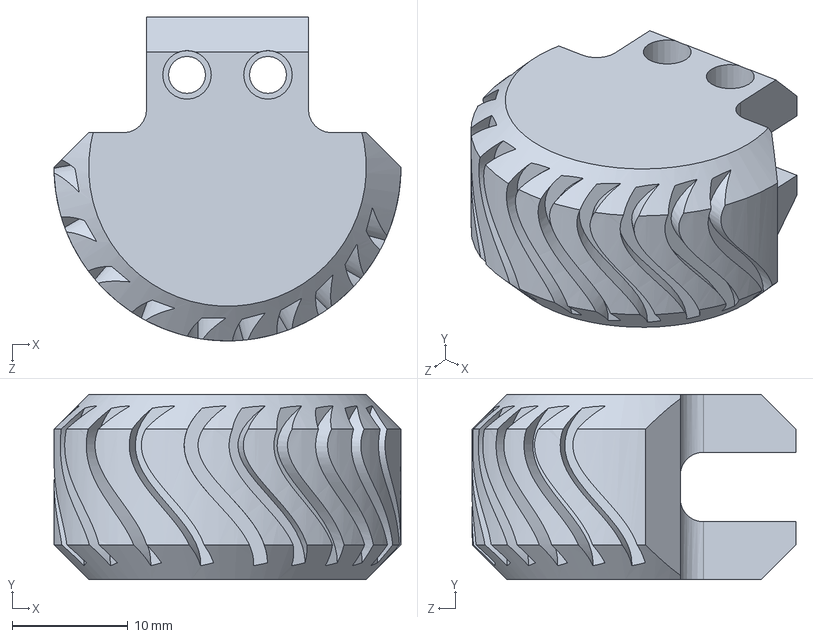
[picture p51: CAD file, 2026-01-23]
1.Hardware/HTDW4438-OpenDogV1.5/足端.SLDPRT
30.0 x 16.0 x 28.0 mm
