Lain-Ego0/HighTorque-MiniDog/1.Hardware/HTDW4438-OpenDogV1.5/滚花热熔螺母 M3-3-4.2.SLDPRT

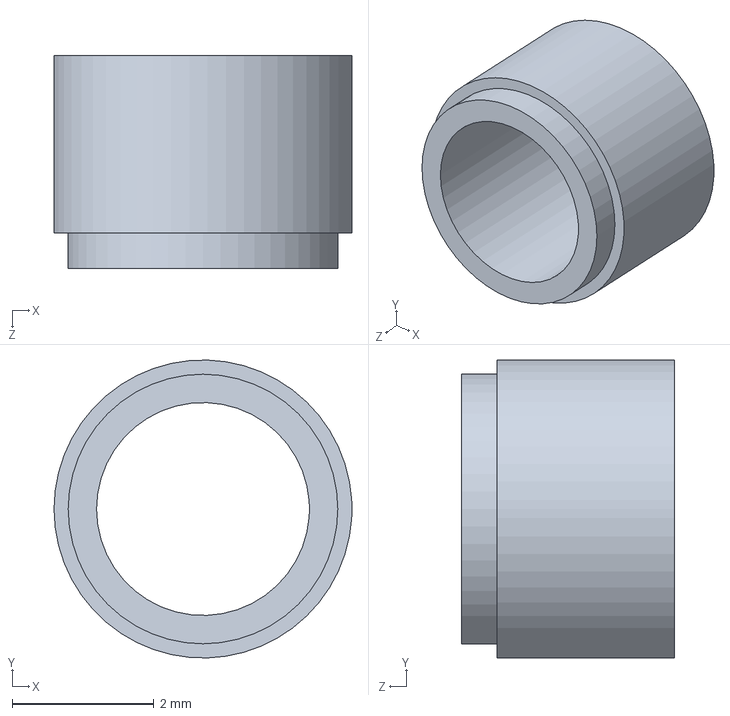
[picture p52: CAD file, 2026-01-23]
1.Hardware/HTDW4438-OpenDogV1.5/滚花热熔螺母 M3-3-4.2.SLDPRT
4.20 x 4.20 x 3.00 mm
