Lain-Ego0/HighTorque-MiniDog/1.Hardware/HTDW4438-OpenDogV1.5/M12开关.SLDPRT

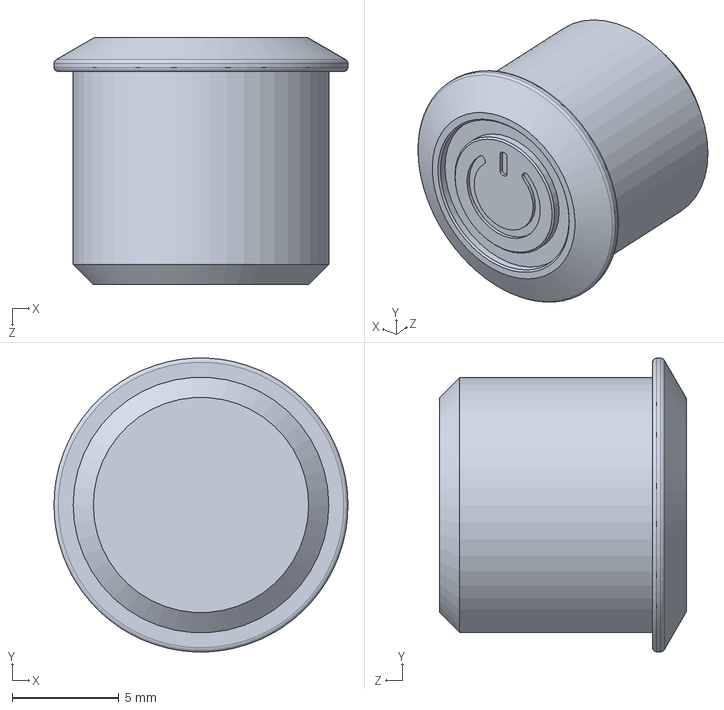
[picture p53: CAD file, 2026-01-23]
1.Hardware/HTDW4438-OpenDogV1.5/M12开关.SLDPRT
13.8 x 13.8 x 11.6 mm
