Lain-Ego0/HighTorque-MiniDog/1.Hardware/HTDW4438-OpenDogV1.5/髋关节连接.SLDPRT

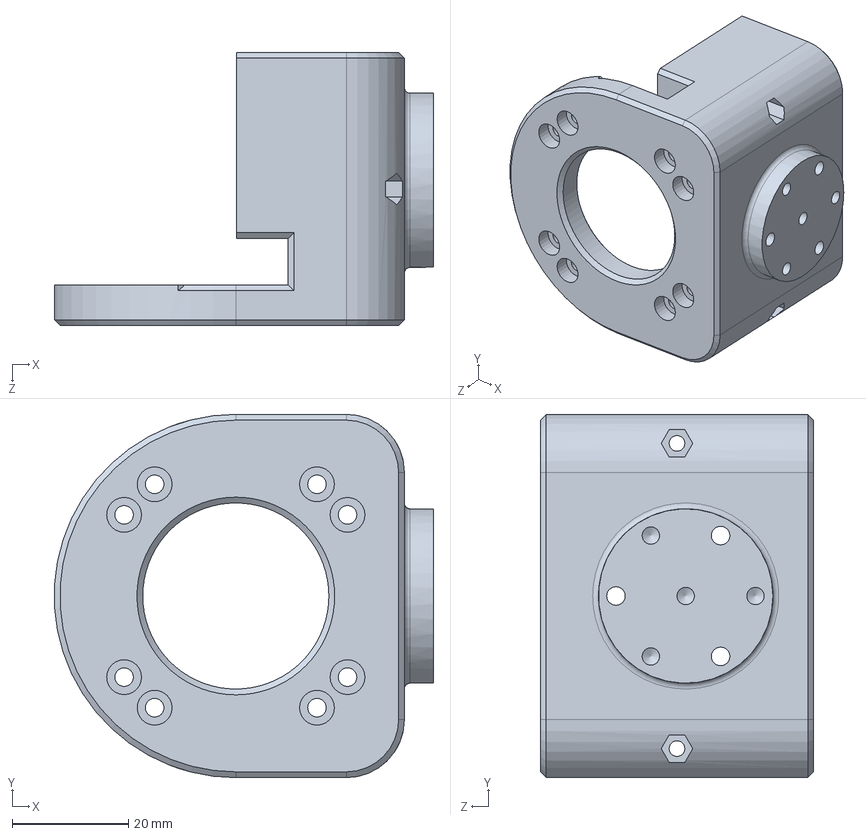
[picture p54: CAD file, 2026-01-23]
1.Hardware/HTDW4438-OpenDogV1.5/髋关节连接.SLDPRT
65.2 x 62.5 x 47.0 mm
