Lain-Ego0/HighTorque-MiniDog/1.Hardware/HTDW4438-OpenDogV1.5/拉杆1.SLDPRT

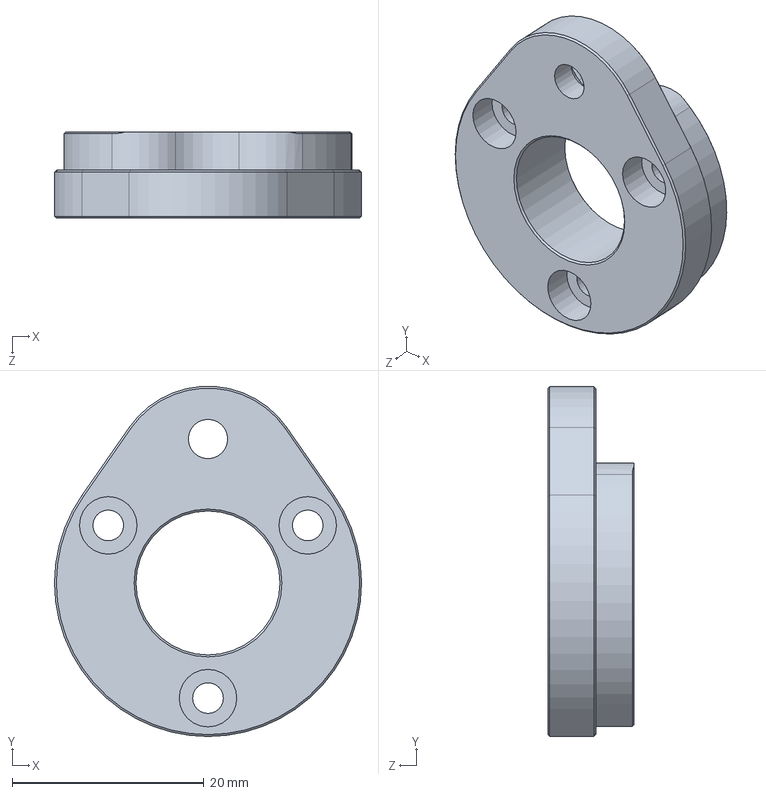
[picture p55: CAD file, 2026-01-23]
1.Hardware/HTDW4438-OpenDogV1.5/拉杆1.SLDPRT
32.0 x 36.5 x 9.00 mm
