Lain-Ego0/HighTorque-MiniDog/1.Hardware/HTDW4438-OpenDogV1.5/点胶倒边内六角-对锁-M3-10 2.SLDPRT

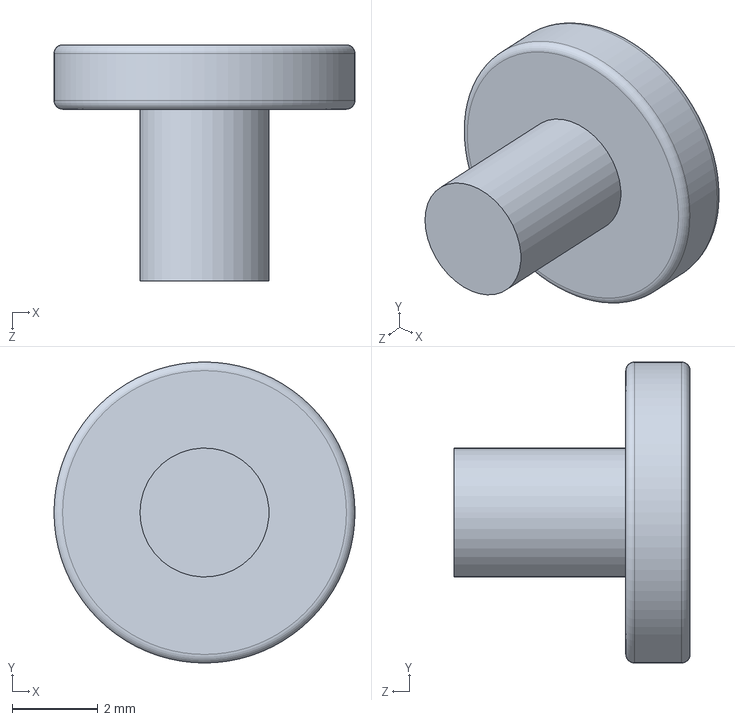
[picture p57: CAD file, 2026-01-23]
1.Hardware/HTDW4438-OpenDogV1.5/点胶倒边内六角-对锁-M3-10 2.SLDPRT
7.00 x 7.00 x 5.50 mm
