Lain-Ego0/HighTorque-MiniDog/1.Hardware/HTDW4438-OpenDogV1.5/点胶倒边内六角-对锁-M3-8 1.SLDPRT

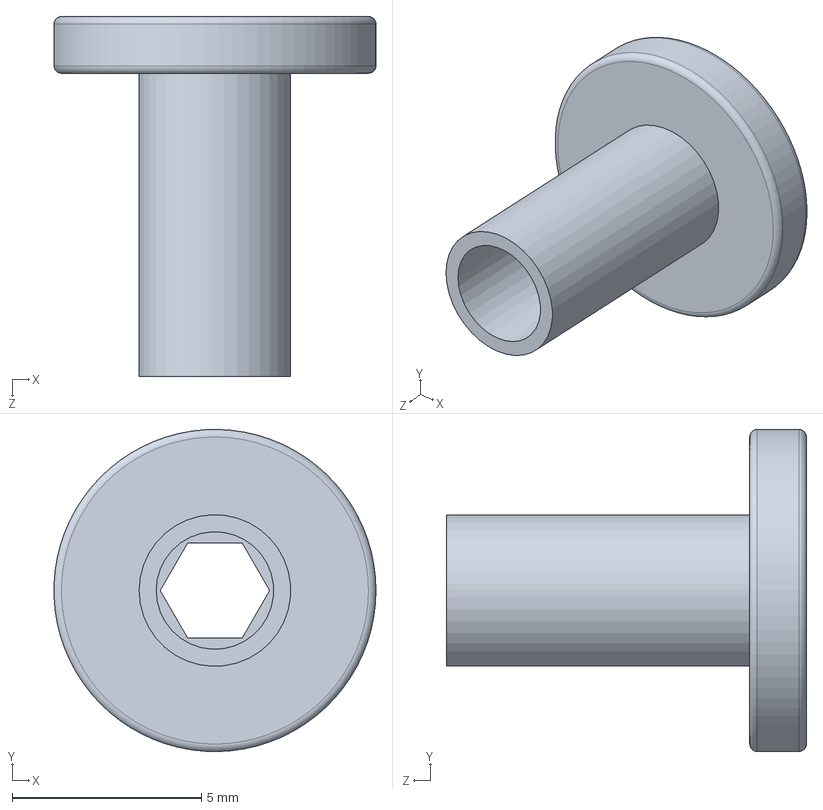
[picture p58: CAD file, 2026-01-23]
1.Hardware/HTDW4438-OpenDogV1.5/点胶倒边内六角-对锁-M3-8 1.SLDPRT
8.50 x 8.50 x 9.50 mm
