Lain-Ego0/HighTorque-MiniDog/1.Hardware/HTDW4438-OpenDogV1.5/大腿电机-小腿电机连接块.SLDPRT

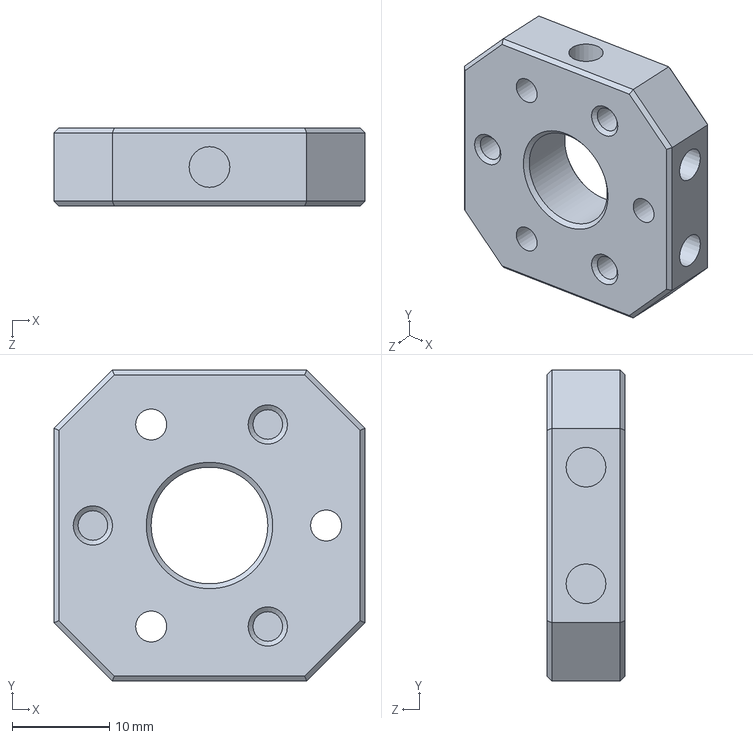
[picture p59: CAD file, 2026-01-23]
1.Hardware/HTDW4438-OpenDogV1.5/大腿电机-小腿电机连接块.SLDPRT
32.0 x 32.0 x 8.00 mm
