Lain-Ego0/HighTorque-MiniDog/1.Hardware/HTDW4438-OpenDogV1.5/角接触球轴承简化 5x13x4.SLDPRT

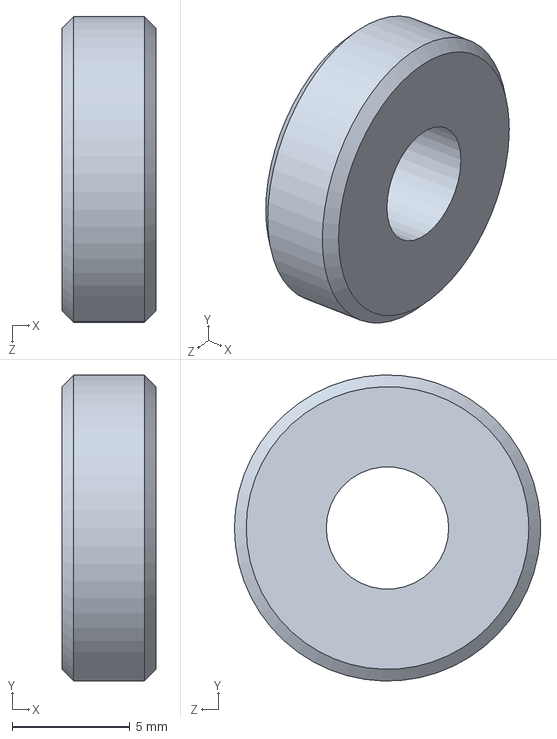
[picture p60: CAD file, 2026-01-23]
1.Hardware/HTDW4438-OpenDogV1.5/角接触球轴承简化 5x13x4.SLDPRT
4.00 x 13.0 x 13.0 mm
