Lain-Ego0/HighTorque-MiniDog/1.Hardware/HTDW4438-OpenDogV1.5/髋部.SLDPRT

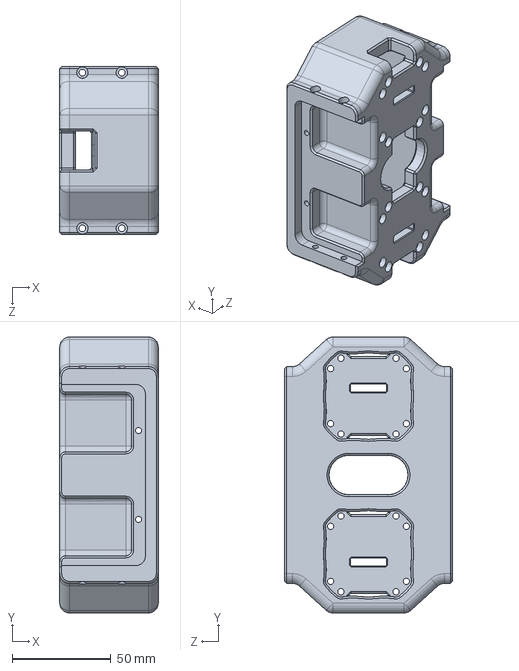
[picture p61: CAD file, 2026-01-23]
1.Hardware/HTDW4438-OpenDogV1.5/髋部.SLDPRT
50.0 x 140.0 x 85.0 mm
