Lain-Ego0/HighTorque-MiniDog/1.Hardware/HTDW4438-OpenDogV1.5/铜柱 M2.5x6.SLDPRT

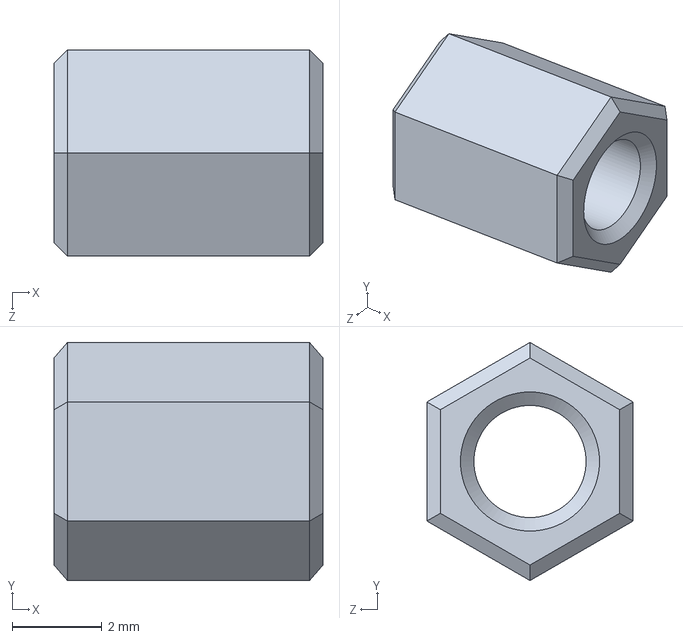
[picture p62: CAD file, 2026-01-23]
1.Hardware/HTDW4438-OpenDogV1.5/铜柱 M2.5x6.SLDPRT
6.00 x 5.31 x 4.60 mm
