Lain-Ego0/HighTorque-MiniDog/1.Hardware/HTDW4438-OpenDogV1.5/GB╱T 70.1-2008[内六角圆柱头螺钉M3×12].SLDPRT

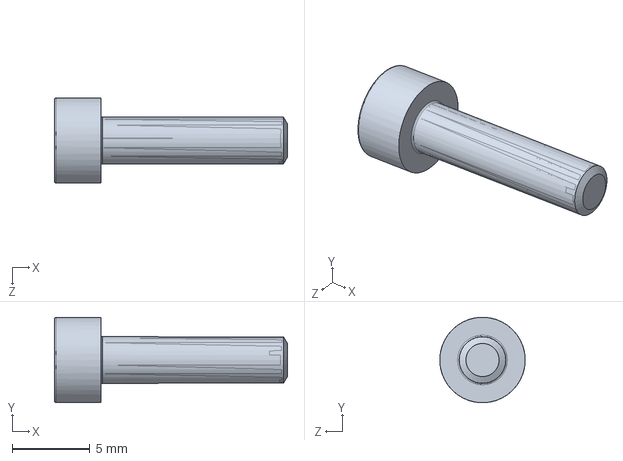
[picture p63: CAD file, 2026-01-23]
1.Hardware/HTDW4438-OpenDogV1.5/GB╱T 70.1-2008[内六角圆柱头螺钉M3×12].SLDPRT
15.0 x 5.50 x 5.50 mm
