Lain-Ego0/HighTorque-MiniDog/1.Hardware/HTDW4438-OpenDogV1.5/HTDW-4438正装0716(URDF0922).SLDPRT

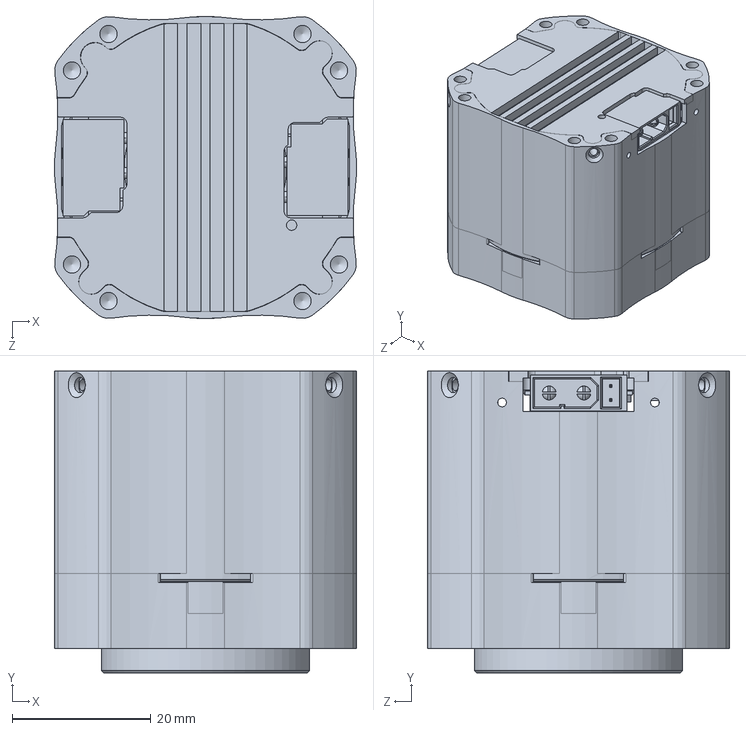
[picture p64: CAD file, 2026-01-23]
1.Hardware/HTDW4438-OpenDogV1.5/HTDW-4438正装0716(URDF0922).SLDPRT
43.5 x 43.4 x 43.5 mm
