Lain-Ego0/HighTorque-MiniDog/1.Hardware/HTDW4438-OpenDogV1.5/电机盖.SLDPRT

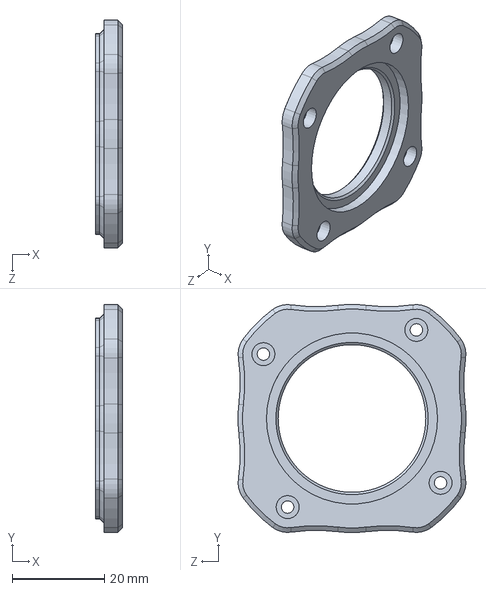
[picture p66: CAD file, 2026-01-23]
1.Hardware/HTDW4438-OpenDogV1.5/电机盖.SLDPRT
5.90 x 49.5 x 49.5 mm
