Lain-Ego0/HighTorque-MiniDog/1.Hardware/HTDW4438-OpenDogV1.5/304搭扣1.SLDPRT

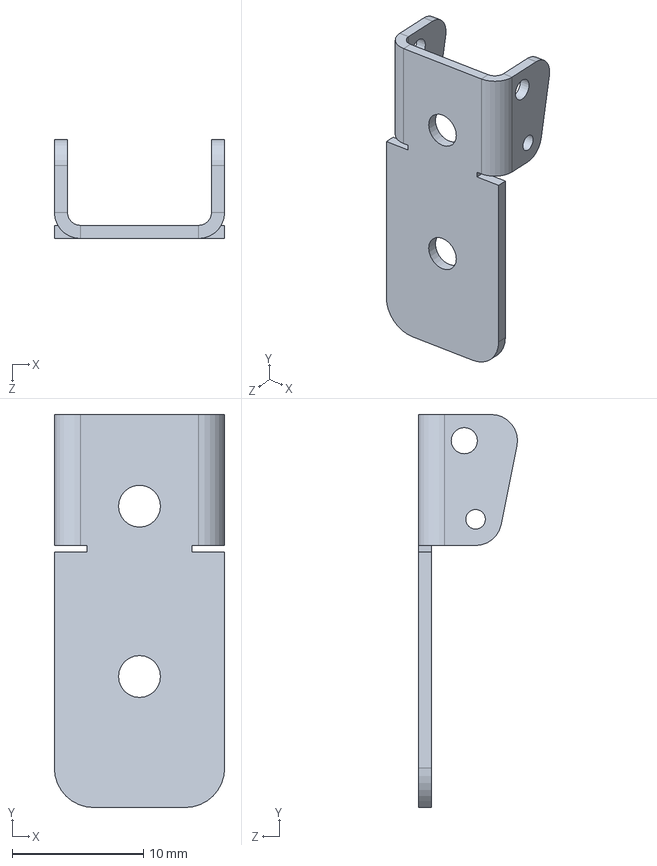
[picture p67: CAD file, 2026-01-23]
1.Hardware/HTDW4438-OpenDogV1.5/304搭扣1.SLDPRT
13.0 x 30.0 x 7.56 mm
