Lain-Ego0/HighTorque-MiniDog/1.Hardware/HTDW4438-OpenDogV1.5/侧面盖线板.SLDPRT

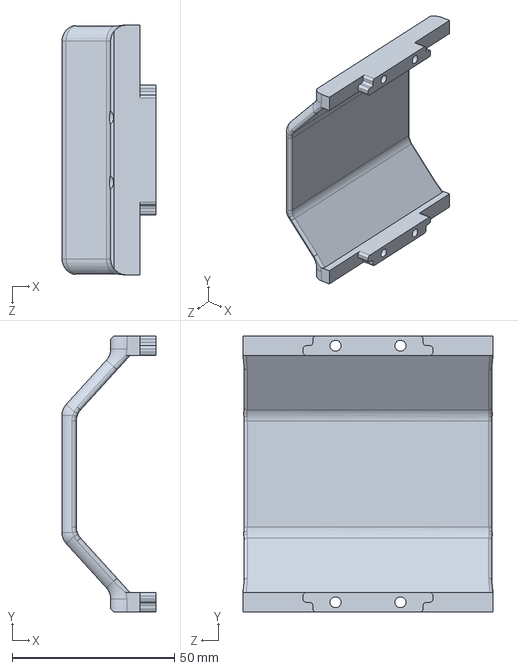
[picture p68: CAD file, 2026-01-23]
1.Hardware/HTDW4438-OpenDogV1.5/侧面盖线板.SLDPRT
29.0 x 85.0 x 77.0 mm
