Lain-Ego0/HighTorque-MiniDog/1.Hardware/HTDW4438-OpenDogV1.5/主控盖与开关-盖板.SLDPRT

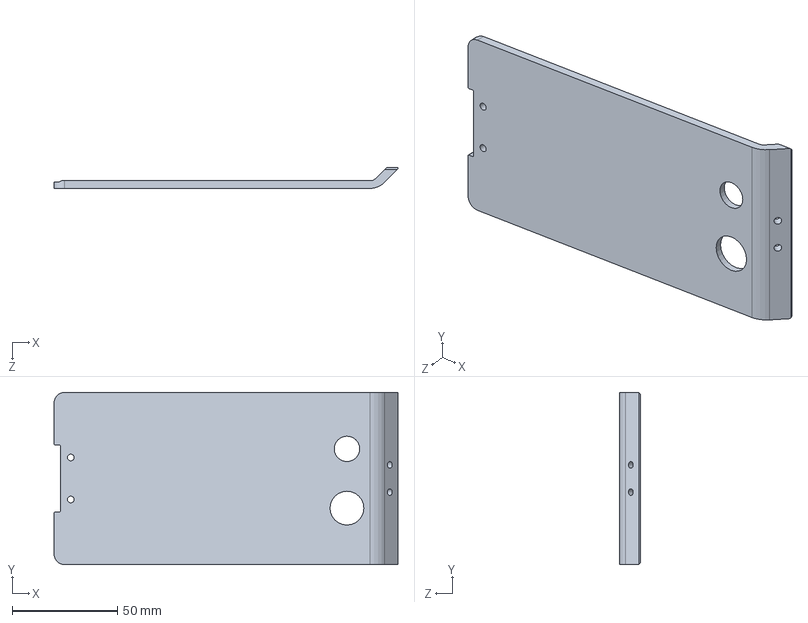
[picture p69: CAD file, 2026-01-23]
1.Hardware/HTDW4438-OpenDogV1.5/主控盖与开关-盖板.SLDPRT
163.7 x 82.0 x 10.0 mm
