Lain-Ego0/HighTorque-MiniDog/1.Hardware/HTDW4438-OpenDogV1.5/3D_刀片接头转接板_2025-04-23 v2.SLDPRT

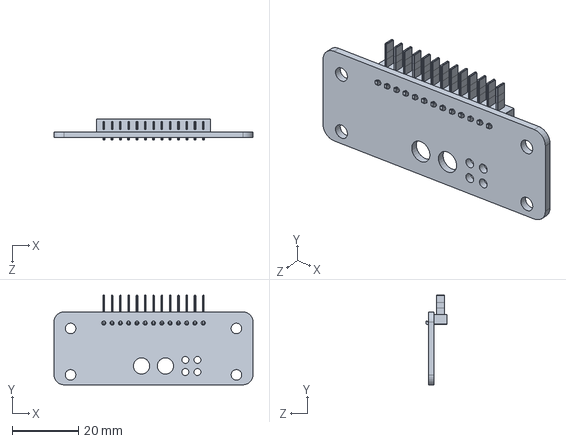
[picture p70: CAD file, 2026-01-23]
1.Hardware/HTDW4438-OpenDogV1.5/3D_刀片接头转接板_2025-04-23 v2.SLDPRT
60.0 x 27.0 x 6.40 mm
