Lain-Ego0/HighTorque-MiniDog/1.Hardware/HTDW4438-OpenDogV1.5/HTP 02B-01-01A-箱体固定板01.SLDPRT

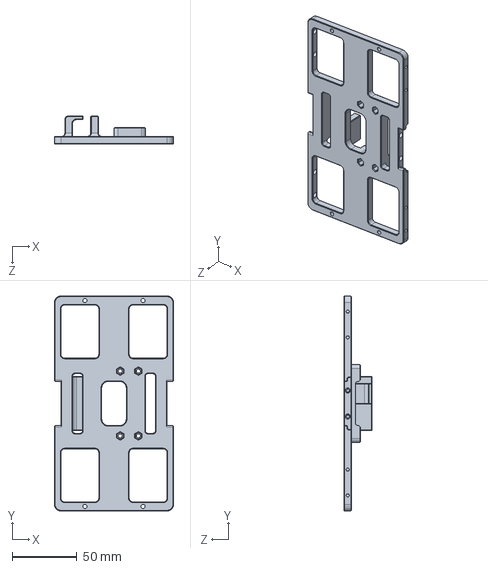
[picture p71: CAD file, 2026-01-23]
1.Hardware/HTDW4438-OpenDogV1.5/HTP 02B-01-01A-箱体固定板01.SLDPRT
92.0 x 166.0 x 21.9 mm
