Lain-Ego0/HighTorque-MiniDog/1.Hardware/HTDW4438-OpenDogV1.5/主控盖与开关.SLDPRT

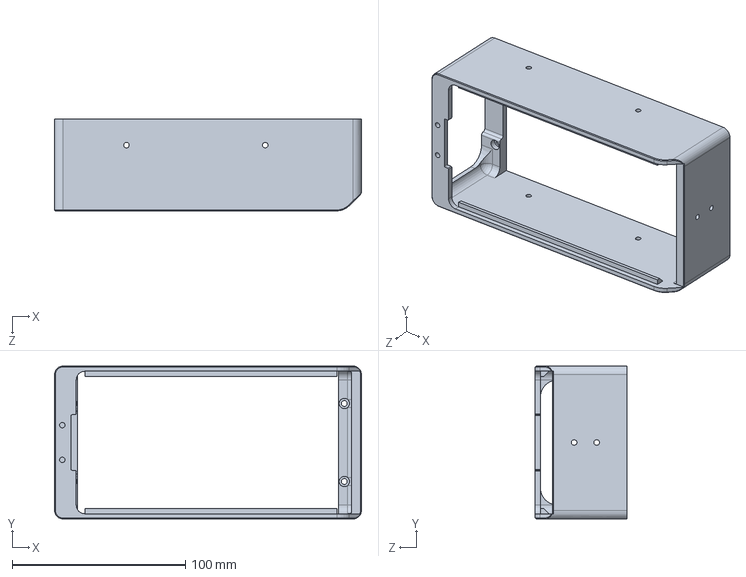
[picture p72: CAD file, 2026-01-23]
1.Hardware/HTDW4438-OpenDogV1.5/主控盖与开关.SLDPRT
177.0 x 88.2 x 52.9 mm
