Lain-Ego0/HighTorque-MiniDog/1.Hardware/HTDW4438-OpenDogV1.5/粉末冶金铜套 5-7-4.SLDPRT

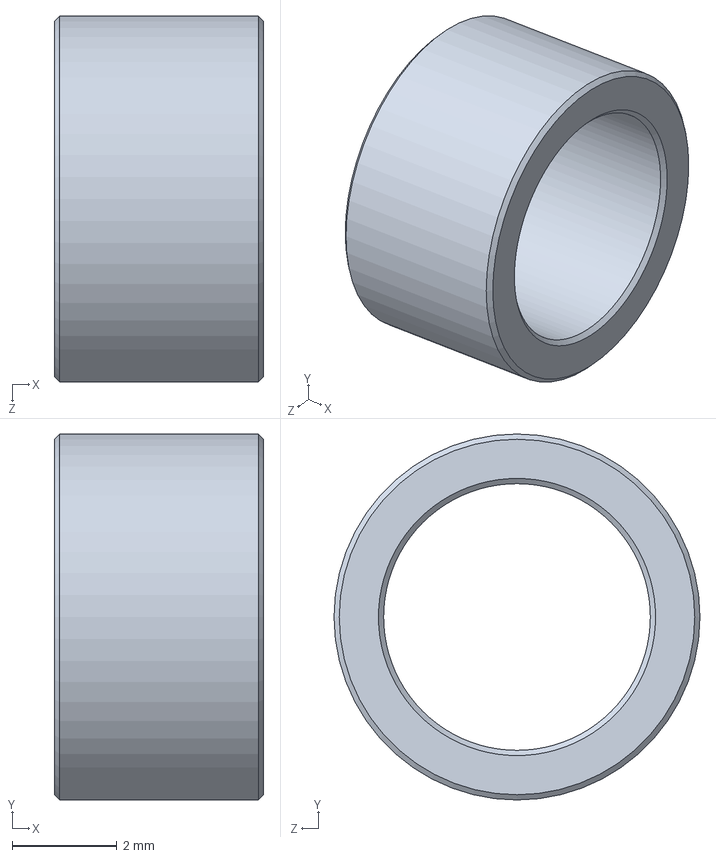
[picture p73: CAD file, 2026-01-23]
1.Hardware/HTDW4438-OpenDogV1.5/粉末冶金铜套 5-7-4.SLDPRT
4.00 x 7.00 x 7.00 mm
