Lain-Ego0/HighTorque-MiniDog/1.Hardware/HTDW4438-OpenDogV1.5/HTPW-24vPower battery V1简化模型.SLDPRT

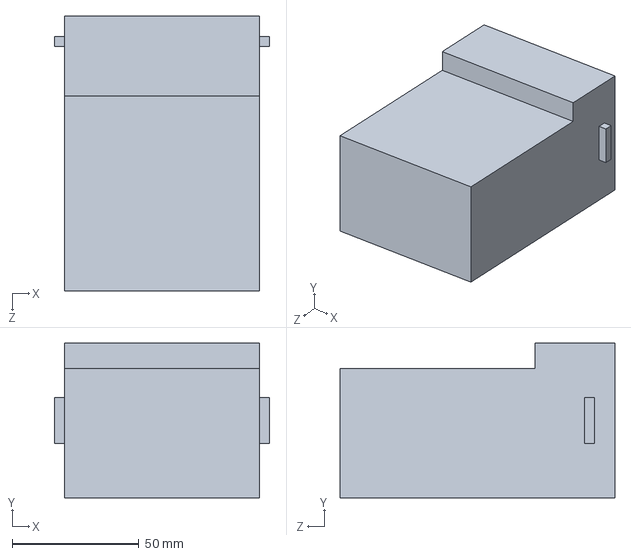
[picture p74: CAD file, 2026-01-23]
1.Hardware/HTDW4438-OpenDogV1.5/HTPW-24vPower battery V1简化模型.SLDPRT
85.0 x 61.0 x 108.5 mm
