Lain-Ego0/HighTorque-MiniDog/1.Hardware/HTDW4438-OpenDogV1.5/扭矩铰链 中号黑色1.SLDPRT

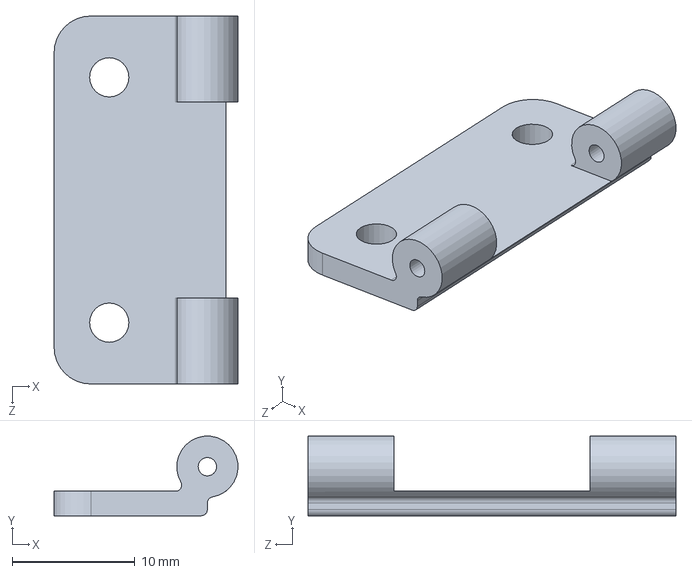
[picture p75: CAD file, 2026-01-23]
1.Hardware/HTDW4438-OpenDogV1.5/扭矩铰链 中号黑色1.SLDPRT
15.0 x 6.49 x 30.0 mm
