Lain-Ego0/HighTorque-MiniDog/1.Hardware/HTDW4438-OpenDogV1.5/HT-03B-主控盒子简化模型.SLDPRT

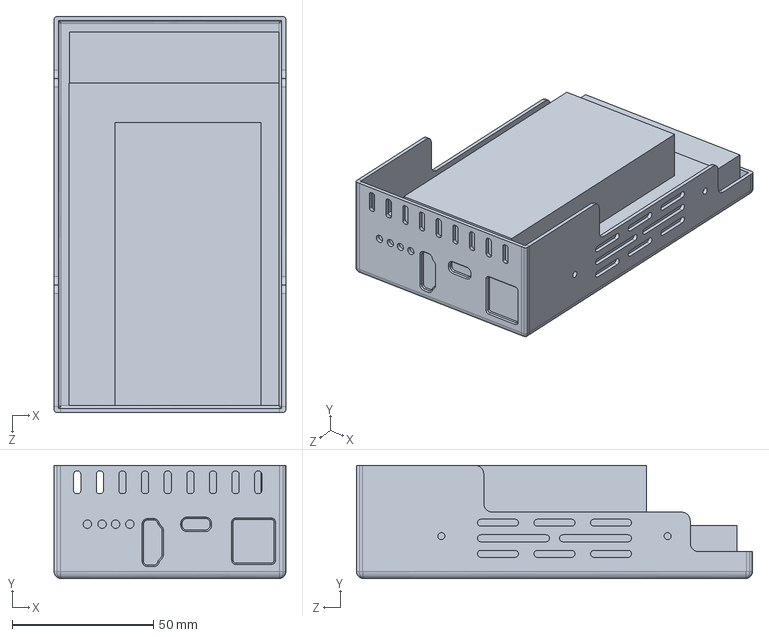
[picture p76: CAD file, 2026-01-23]
1.Hardware/HTDW4438-OpenDogV1.5/HT-03B-主控盒子简化模型.SLDPRT
82.0 x 40.0 x 140.0 mm
