Lain-Ego0/HighTorque-MiniDog/1.Hardware/HTDW4438-OpenDogV1.5/拉杆输出盘-发加工版本.SLDPRT

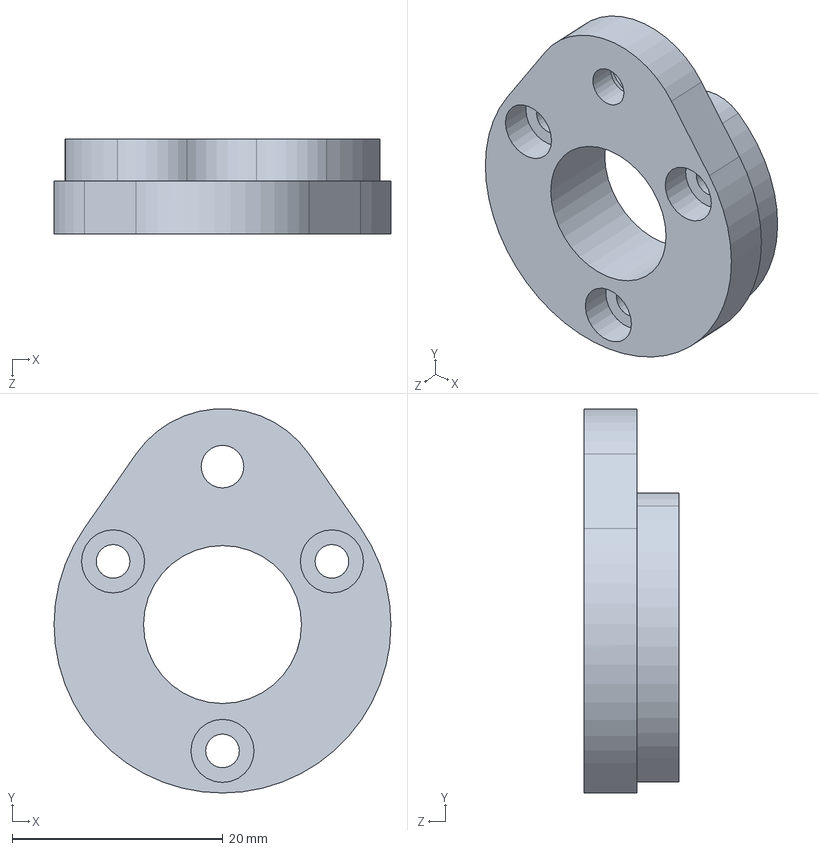
[picture p78: CAD file, 2026-01-23]
1.Hardware/HTDW4438-OpenDogV1.5/拉杆输出盘-发加工版本.SLDPRT
32.0 x 36.5 x 9.00 mm
