Lain-Ego0/HighTorque-MiniDog/1.Hardware/HTDW4438-OpenDogV1.5/M16开关.SLDPRT

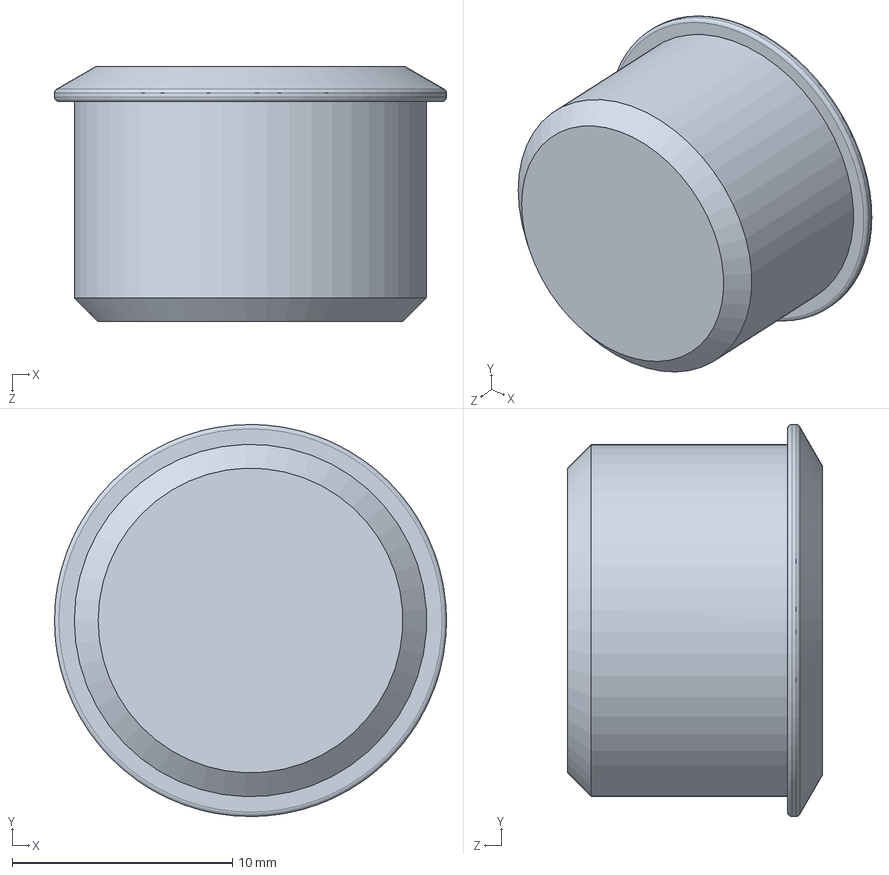
[picture p79: CAD file, 2026-01-23]
1.Hardware/HTDW4438-OpenDogV1.5/M16开关.SLDPRT
17.8 x 17.8 x 11.6 mm
