Lain-Ego0/HighTorque-MiniDog/(list of files, cad)

Other CAD files:
1.Hardware/htdw_4438_urdf/meshes/RL_foot.STL
1.Hardware/htdw_4438_urdf/meshes/RL_thigh.STL
1.Hardware/HTDW4438-OpenDogV1.5/大腿外侧1.SLDPRT
1.Hardware/htdw_4438_urdf/meshes/FL_hip.STL
1.Hardware/htdw_4438_urdf/meshes/RR_calf.STL
1.Hardware/htdw_4438_urdf/meshes/RL_calf.STL
1.Hardware/htdw_4438_urdf/meshes/RR_thigh.STL
1.Hardware/htdw_4438_urdf/meshes/FR_foot.STL
1.Hardware/htdw_4438_urdf/meshes/FL_calf.STL
1.Hardware/htdw_4438_urdf/meshes/RL_hip.STL
1.Hardware/htdw_4438_urdf/meshes/RR_foot.STL
1.Hardware/htdw_4438_urdf/meshes/FL_thigh.STL
1.Hardware/HTDW4438-OpenDogV1.5/铝-CNC连杆.SLDPRT
1.Hardware/HTDW4438-OpenDogV1.5/扭矩铰链 中号黑色2.SLDPRT
1.Hardware/HTDW4438-OpenDogV1.5/大腿内侧1.SLDPRT
1.Hardware/HTDW4438-OpenDogV1.5/点胶倒边内六角-对锁-M3-8 2.SLDPRT
1.Hardware/HTDW4438-OpenDogV1.5/小腿2.SLDPRT
1.Hardware/HTDW4438-OpenDogV1.5/大腿外侧2.SLDPRT
