Lain-Ego0/HighTorque-MiniDog/3.Document/高擎电机手册/HTDW-4438-32-NE-安装图纸v0726.pdf

4 30 3

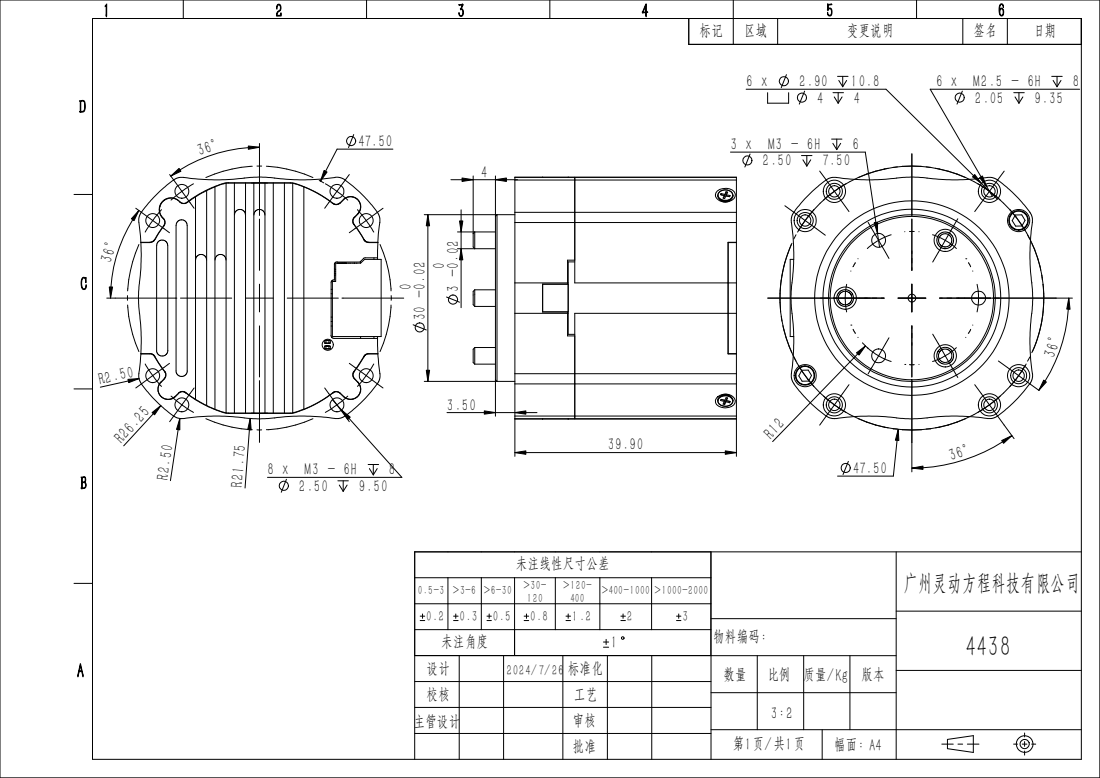
[picture p118: page 1]
物料编码：

标记 | 区域 | 变更说明 | 签名 | 日期

未注线性尺寸公差 | | 广州灵动方程科技有限公司

0.2 | 0.3 | 0.5 | 0.8 | 1.2 | 2 | 3
未注角度 | | | 1
设计 | | 2024/7/26 | 标准化 | | | 数量 | 比例 | 质量/Kg | 版本
校核 | | | 工艺
主管设计 | | | 审核

3:2
第1页/共1页 | 幅面：A4
