Lain-Ego0/HighTorque-MiniDog/3.Document/7路CAN主控盒子资料/C++版本程序/livelybot_sdk/src/livelybot_bringup/src/motor_rerun.cpp

#include "ros/ros.h"
#ifndef RELEASE
#include "robot.h"
#else
#include "livelybot_serial/hardware/robot.h"
#endif
#include <iostream>
#include <thread>
#include <condition_variable>

int main(int argc, char **argv)
{
    ros::init(argc, argv, "test_motor");
    ros::NodeHandle n;
    ros::Rate r(200);
    livelybot_serial::robot rb;
    //rb.set_motor_runzero();     // 电机上电自动回零
    const int motor_num = rb.Motors.size();
    ROS_INFO("ALL Motor: %d\n", motor_num);
    ROS_INFO("\033[1;32mSTART\033[0m");
    // ========================== singlethread send =====================
    int cont = 0;
    float angle = 0.2;
    while (ros::ok()) // 此用法为逐个电机发送控制指令
    {
        /////////////////////////send
        for (int i = 0; i < motor_num; i++)
        {
            if(i < (int)motor_num/2)
            {
                rb.Motors[i]->pos_vel_MAXtqe(angle, 0.1, 10);  // 这里为了方便出厂测试，直接使用了 pos_vel_MAXtqe 函数（不推荐）
                // rb.Motors[i]->fresh_cmd_int16(0, 0, 0, 0, 0, 0, 0, 0, 0);
            }
            else
            {
                rb.Motors[i]->pos_vel_MAXtqe(-angle, 0.1, 10);  // 这里为了方便出厂测试，直接使用了 pos_vel_MAXtqe 函数（不推荐）
                // rb.Motors[i]->fresh_cmd_int16(0, 0, 0, 0, 0, 0, 0, 0, 0);
            }
        }
        cont++;
        if(cont>=250)
        {
            cont = 0;
            angle*=-1;
        }
        rb.motor_send_2();
        ////////////////////////recv
        for (motor *m : rb.Motors)
        {
            motor_back_t motor;
            motor = *m->get_current_motor_state();
            ROS_INFO("ID:%2d,mode: %2d,fluat: %2X,pos: %8f,vel: %8f,tor: %8f", motor.ID, motor.mode, motor.fault, motor.position, motor.velocity, motor.torque);
        }
        ros::spinOnce();
        r.sleep();
    }

    ros::spin();
    return 0;
}
