Lain-Ego0/HighTorque-MiniDog/3.Document/7路CAN主控盒子资料/C++版本程序/livelybot_sdk/src/livelybot_serial/include/hardware/robot.h

#ifndef _ROBOT_H_
#define _ROBOT_H_
#include <iostream>
#include "canboard.h"
#include "ros/ros.h"
#include <thread>
#include <initializer_list>
#include <fstream>

#include <libserialport.h>
#include <dirent.h>
#include <algorithm>

#include <dynamic_reconfigure/server.h>
#include <livelybot_serial/robot_dynamic_config_20Config.h>
#include <sensor_msgs/JointState.h>

#include "sensor_msgs/Imu.h"
#include <cmath>
#include <boost/bind.hpp>


namespace livelybot_serial
{
    class robot
    {
    private:
        std::string robot_name, Serial_Type;
        int CANboard_num, Seial_baudrate;
        ros::NodeHandle n;
        std::vector<canboard> CANboards;
        std::vector<std::string> str;
        std::string SDK_version2 = "4.4.6"; // SDK版本
        std::atomic<bool> publish_joint_state;
        ros::Publisher joint_state_pub_;
        std::thread pub_thread_;
        std::thread error_check_thread_;
        fun_version fun_v = fun_v1;
        float slave_v = 3.0f;
        int control_type;

        /* IMU相关 */
        bool imu_limt_flag = false;
        bool imu_dir = false;
        float imu_limt_num, roll, pitch;
        ros::Subscriber imu_sub;

        int motor_timeout_ms = 0;

    public:
        std::vector<lively_serial *> ser;
        std::vector<motor *> Motors;
        std::vector<canport *> CANPorts;
        std::vector<std::thread> ser_recv_threads;
        int motor_position_limit_flag = 0;
        int motor_torque_limit_flag = 0;

        robot();
        ~robot();

        void publishJointStates();
        void detect_motor_limit();
        void motor_send_2();
        int serial_pid_vid(const char *name, int *pid, int *vid);
        int serial_pid_vid(const char *name);
        std::vector<std::string> list_serial_ports(const std::string& full_prefix);
        void init_ser();
        void check_error();
        int check_serial_dev_exist(int);
        void set_port_motor_num();
        void send_get_motor_state_cmd();
        void send_get_motor_version_cmd();
        void chevk_motor_connection_position();
        void chevk_motor_connection_version();
        void set_stop();
        void set_reset();
        void set_reset_zero();
        void set_reset_zero(std::initializer_list<int> motors);
        void set_motor_runzero();
        void set_timeout(int16_t t_ms);
        void set_timeout(uint8_t portx, int16_t t_ms);
        void motor_version_detection();
        void set_data_reset();
        void canboard_bootloader();
        void canboard_fdcan_reset();
        bool imu_limt();
        void imuCallback(const sensor_msgs::Imu::ConstPtr& msg);
    };
}
#endif
