Lain-Ego0/HighTorque-MiniDog/3.Document/7路CAN主控盒子资料/C++版本程序/livelybot_sdk/src/livelybot_oled/src/oled_interface.cpp

#include <stdio.h>
#include <string.h>
#include <stdlib.h>
#include <unistd.h>
#include "sensor_actuator_status.hpp"
#include <ros/ros.h>
#include <sensor_msgs/Imu.h>
#include <sensor_msgs/JointState.h>
#include <std_msgs/Float32.h>
#include <std_msgs/Int32.h>
#include <std_msgs/UInt8.h>
#include <tf/transform_datatypes.h>
#include "ip_addr.hpp"
#include <thread>
#include <chrono>

#define _2PI_ 6.2831853

Sensor_actuator_status *status;

uint8_t imu_flag = 0;
float rpy[3];

int can_port_num;
int motor_num[4];

void imu_callback(const sensor_msgs::Imu::ConstPtr& data);
void motor_callback(const sensor_msgs::JointState& data);
void battery_level_callback(const std_msgs::UInt8::ConstPtr& msg);
void fsm_state_callback(const std_msgs::Int32::ConstPtr& msg);

void oled_mission(ros::NodeHandle &n)
{
    ros::Rate r(10.0);   
    // 获取配置参数，CAN线与电机数量
    if (n.getParam("robot/CANboard/No_" + std::to_string(1) + "_CANboard/CANport_num", can_port_num))
    {
        ROS_INFO("Robot has %d CAN", can_port_num);
        for(int i = 0; i < can_port_num; i++)
        {
            if (n.getParam("robot/CANboard/No_" + std::to_string(1) + "_CANboard/CANport/CANport_" + std::to_string(i+1) + "/motor_num", motor_num[i]))
            {
                //TODO
                ROS_INFO("can_%d has %d motor", i+1, motor_num[i]);
            }
            else
            {
                ROS_ERROR("Faile to get params motor_num");
            }
        }
    }
    else
    {
        ROS_ERROR("Faile to get params can_port_num");
    }
    ROS_INFO("all_motor_num: %d", motor_num[0]+motor_num[1]+motor_num[2]+motor_num[3]);
    // 创建电机status的对象
    status = new Sensor_actuator_status(motor_num[0], motor_num[1], motor_num[2], motor_num[3]);

    // 订阅imu_data话题
    ros::Subscriber sub = n.subscribe("/imu/data", 1, imu_callback);
    ros::Subscriber m_sub = n.subscribe("/error_joint_states", 1, motor_callback); // error_joint_states
    ros::Subscriber battery_level_sub = n.subscribe("/battery_level", 1, battery_level_callback);
    ros::Subscriber fsm_state_sub = n.subscribe("/fsm_state", 1, fsm_state_callback);
    int i = 0;
    update_ip_addr();
    while(ros::ok())
    {
        r.sleep();
        ros::spinOnce();
        i++;
        if(i>=10)
        {
            i = 0;
            update_ip_addr();
        }
        status->send_ip_addr(get_ip_data_u32_all(), 3);
        std::this_thread::sleep_for(std::chrono::milliseconds(100));
        if(imu_flag)
        {
            status->send_imu_status(0, rpy);
        }
        imu_flag = 1;
    }

    // return 0;
}

void imu_callback(const sensor_msgs::Imu::ConstPtr& data) {
    // 提取IMU姿态角
    static int cnt = 0;
    double roll, pitch, yaw;
    tf::Quaternion q(
        data->orientation.x,
        data->orientation.y,
        data->orientation.z,
        data->orientation.w
    );
    tf::Matrix3x3 rot_mat(q);
    rot_mat.getRPY(roll, pitch, yaw);
    // ROS_INFO("Roll: %.2f, Pitch: %.2f, Yaw: %.2f", roll, pitch, yaw);
    float rpy[3];
    rpy[0] = roll;
    rpy[1] = pitch;
    rpy[2] = yaw;
    status->send_imu_status(1, rpy);
    std::this_thread::sleep_for(std::chrono::milliseconds(100));
    imu_flag = 0;
}

void motor_callback(const sensor_msgs::JointState& data)
{
    unsigned char motor_status[64] = {1,0,1,0,1,1,0,1,1,0,0,1,0,0,0,0,0,0,0,0,0,0,0,0};
    int all_motor_num;
    all_motor_num = motor_num[0] + motor_num[1] + motor_num[2] + motor_num[3];
    for(int i = 0; i < all_motor_num; i++)
    {
        if(data.position[i] < -900.0)
        {
            motor_status[i] = 0;
        }
        else
        {
            motor_status[i] = 1;
        }
    }
    status->send_motor_status(motor_status);
    std::this_thread::sleep_for(std::chrono::milliseconds(100));
}

void battery_level_callback(const std_msgs::UInt8::ConstPtr& msg)
{
    // ROS_INFO("receive level:%d", msg->data);
    status->send_battery_level(msg->data);
    std::this_thread::sleep_for(std::chrono::milliseconds(100));
}

void fsm_state_callback(const std_msgs::Int32::ConstPtr& msg)
{
    // ROS_INFO("receive fsm_state:%d", msg->data);
    status->send_fsm_state(msg->data);
    std::this_thread::sleep_for(std::chrono::milliseconds(100));
}
