Lain-Ego0/HighTorque-MiniDog/3.Document/7路CAN主控盒子资料/C++版本程序/livelybot_sdk/src/livelybot_oled/include/ip_addr.hpp

#include <cstdint>

#define LO_NET      "lo"
#define ETHERNET    "none"
#define WLAN        "wlan0"

void update_ip_addr(void);
uint32_t get_ip_data_u32(uint8_t i);
uint32_t* get_ip_data_u32_all(void);
