Lain-Ego0/HighTorque-MiniDog/3.Document/7路CAN主控盒子资料/C++版本程序/livelybot_sdk/src/livelybot_description/robot_param/70dof_HPM6E00_model_test_Orin_params.yaml

robot:
  robot_name: "multi-motor test"
  Serial_Type: "/dev/ttyACM"
  Seial_baudrate: 4000000
  CAN_Type: "CAN-FD BRS" # "CAN-FD"\"CAN-FD BRS"\"CAN 2.0B"
  control_type: 9  # 运行模式
  imu_limt_flag: false  # 角度限制开关
  imu_dir: false        # IMU安装方向
  imu_limt_num: 1.0    # 角度限制值（幅度制, 范围：[0, 1.57)）
  motor_timeout_ms: 0  # 设置电机的超时时间（单位：毫秒），取值范围：[0, 32760]，如果电机在指定时间内未接收到新的控制指令，将进入阻尼模式。将此值设为0表示禁用超时时间功能。
  CANboard_num: 1
  CANboard:
    No_1_CANboard:
      CANport_num: 7
      CANport:
        CANport_1:
          serial_id: 1
          motor_num: 10
          motor:
            motor1:
                type: "4438_32"
                id: 1
                name: "L_toe_up"
                num: 1
                pos_limit_enable: false
                pos_upper: 5
                pos_lower: -5
                tor_limit_enable: false
                tor_upper: 5
                tor_lower: -3
            motor2:
                type: "5047_36"
                id: 2
                name: "L_calf"
                num: 2
                pos_limit_enable: false
                pos_upper: 5
                pos_lower: -5
                tor_limit_enable: false
                tor_upper: 5
                tor_lower: -3
            motor3:
                type: "5047_36"
                id: 3
                name: "L_hip"
                num: 3
                pos_limit_enable: false
                pos_upper: 5
                pos_lower: -5
                tor_limit_enable: false
                tor_upper: 5
                tor_lower: -3
            motor4:
                type: "5047_36"
                id: 4
                name: "L_hip2"
                num: 4
                pos_limit_enable: false
                pos_upper: 5
                pos_lower: -5
                tor_limit_enable: false
                tor_upper: 5
                tor_lower: -3
            motor5:
                type: "5047_36"
                id: 5
                name: "L_thigh"
                num: 5
                pos_limit_enable: false
                pos_upper: 5
                pos_lower: -5
                tor_limit_enable: false
                tor_upper: 5
                tor_lower: -3
            motor6:
                type: "5047_36"
                id: 6
                name: "L_thigh"
                num: 5
                pos_limit_enable: false
                pos_upper: 5
                pos_lower: -5
                tor_limit_enable: false
                tor_upper: 5
                tor_lower: -3
            motor7:
                type: "5047_36"
                id: 7
                name: "L_thigh"
                num: 5
                pos_limit_enable: false
                pos_upper: 5
                pos_lower: -5
                tor_limit_enable: false
                tor_upper: 5
                tor_lower: -3
            motor8:
                type: "5047_36"
                id: 8
                name: "L_thigh"
                num: 5
                pos_limit_enable: false
                pos_upper: 5
                pos_lower: -5
                tor_limit_enable: false
                tor_upper: 5
                tor_lower: -3
            motor9:
                type: "5047_36"
                id: 9
                name: "L_thigh"
                num: 5
                pos_limit_enable: false
                pos_upper: 5
                pos_lower: -5
                tor_limit_enable: false
                tor_upper: 5
                tor_lower: -3
            motor10:
                type: "5047_36"
                id: 10
                name: "L_thigh"
                num: 5
                pos_limit_enable: false
                pos_upper: 5
                pos_lower: -5
                tor_limit_enable: false
                tor_upper: 5
                tor_lower: -3
        CANport_2:
          serial_id: 2
          motor_num: 10
          motor:
            motor1:
                type: "4438_32"
                id: 1
                name: "L_toe_up"
                num: 1
                pos_limit_enable: false
                pos_upper: 5
                pos_lower: -5
                tor_limit_enable: false
                tor_upper: 5
                tor_lower: -3
            motor2:
                type: "5047_36"
                id: 2
                name: "L_calf"
                num: 2
                pos_limit_enable: false
                pos_upper: 5
                pos_lower: -5
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
                tor_upper: 5
                tor_lower: -3
            motor10:
                type: "5047_36"
                id: 10
                name: "L_thigh"
                num: 5
                pos_limit_enable: false
                pos_upper: 5
                pos_lower: -5
                tor_limit_enable: false
                tor_upper: 5
                tor_lower: -3
