Lain-Ego0/HighTorque-MiniDog/(commit log)

2025-12-14 Update Hardware
    [12mm铜柱.SLDPRT, 12mm铜柱.STEP, 3D_刀片接头转接板_2025-04-23 v2.SLDPRT, 3D_刀片接头转接板_2025-04-23 v2.step, 4-14-4平推滚子.SLDPRT, 4-14-4平推滚子.STEP, 4xM3x20 塞打.SLDPRT, GB╱T 70.1-2008[内六角圆柱头螺钉M3×12].sldprt]
2025-12-17 Add and update BOM and CAD files
    Added BOM.xlsx and a new SLDPRT file. Updated several existing SLDPRT and SLDASM CAD files with new versions.
    [BOM.xlsx, GB╱T 70.1-2008[内六角圆柱头螺钉M3×8].sldprt, HTDW-4438正装0716(URDF0922).SLDPRT, 打印件-髋关节连接.SLDPRT]
2025-12-20 Update IMU ROS2control
    [dmbot_imu.urdf.xacro]
2026-01-05 Update V3
    [12mm铜柱.SLDPRT, 12mm铜柱.STEP, 304搭扣1.SLDPRT, 304搭扣2.SLDPRT, 304搭扣3.SLDPRT, 304搭扣4.SLDPRT, 3D_刀片接头转接板_2025-04-23 v2.SLDPRT, 3D_刀片接头转接板_2025-04-23 v2.step]
2026-01-23 Update URDF/new structure
    [304搭扣1.SLDPRT, 304搭扣2.SLDPRT, 304搭扣3.SLDPRT, 304搭扣4.SLDPRT, 3D_刀片接头转接板_2025-04-23 v2.SLDPRT, FL_calf.STL, FL_foot.STL, FL_hip.STL]
2026-01-23 Migrate quadruped_robot V1.1 to htdw-4438 V1.2
    Renamed and reorganized the quadruped_robot V1.1 hardware package to htdw-4438 V1.2, including all configuration, launch, mesh, and URDF files. Added new mesh files for FR_foot and RL_foot, and included export.log and URDF.SLDASM.csv for the new version. Removed corresponding files from the old package.
    [FL_calf.STL, FL_foot.STL, FL_hip.STL, FL_thigh.STL, FR_calf.STL, FR_foot.STL, FR_hip.STL, FR_thigh.STL]
2026-01-25 Add livelybot_sdk initial source, scripts, and docs
    Initial import of the livelybot_sdk, including ROS packages for robot control, CAN board, motor, power, OLED, serial communication, and IMU integration. Adds shell scripts for launching and testing, configuration files, C++/Python source code, message definitions, and comprehensive documentation for setup, usage, and configuration.
    [Yesense.cfg, robot_dynamic_config_20.cfg]
2026-01-26 Create 新建 文本文档.txt
2026-01-28 删除重复文件夹，添加论文PDF
2026-01-29 修改URDF版本
    [FL_calf.STL, FL_foot.STL, FL_hip.STL, FL_thigh.STL, FR_calf.STL, FR_foot.STL, FR_hip.STL, FR_thigh.STL]
2026-01-29 添加了相关文献的PDF
2026-03-04 docs(README)添加英文版本
2026-03-19 [fix]修正URDF版本
    [FL_calf.STL, FL_foot.STL, FL_hip.STL, FL_thigh.STL, FR_calf.STL, FR_foot.STL, FR_hip.STL, FR_thigh.STL]
2026-03-19 [fix]修正README表述
2026-03-19 [fix]修正表达问题
